leslieecv/EL6050_project/Examen/Imagenes/Presentación/loraGE2.png

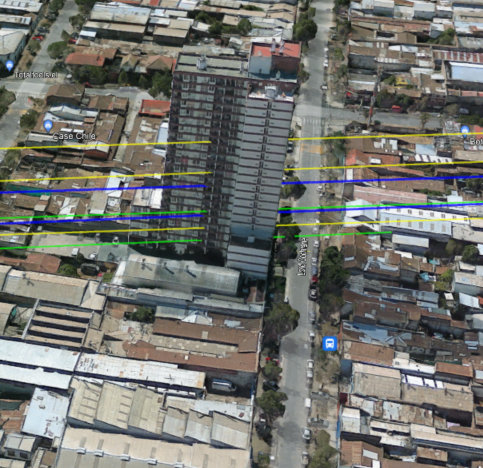
Examen/Imagenes/Presentación/loraGE2.png
