leslieecv/EL6050_project/Examen/Imagenes/Presentación/P_fig3.jpg

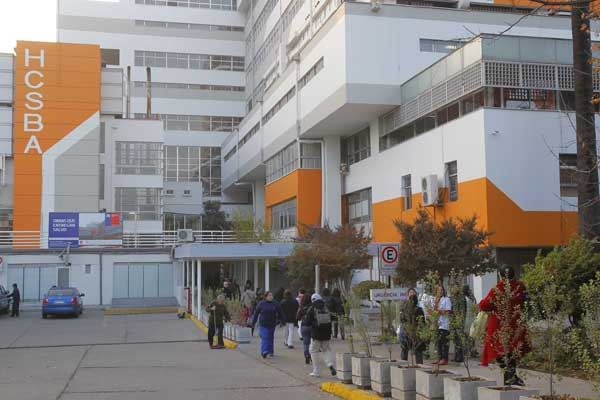
Examen/Imagenes/Presentación/P_fig3.jpg
