leslieecv/EL6050_project/README.md

# Proyecto de curso EL6050

- Leslie Cárdenas
- Nicolás Ruminot

Link de repositorio:  

[https://github.com/leslieecv/EL6050_project.git](https://github.com/leslieecv/EL6050_project.git)
