leslieecv/EL6050_project/T3/lista_compras.pdf

# | Componente | Símbolo en la PCB | Valor | Valor secundario Descripción | Cantidad/placa Precio/unidad Precio/cantidad Link compra

0-1 Placa diseñada | No se puede manufacturar solo una unidad | 1 | $640 | $640
| | | | | https://cart.jlcpcb.com/quote?rand=0.016247681288237947
0-2 Placa diseñada | | | (US$4) No considera en el total | 5 | $640 | $3.198
0-3 Envío placa | | | (US$23.99) Para 1 o 5 placas | | | $19.328
1 Conector SMA | ANTENA | | Conector jack para antena | 1 | $1.125 | $1.125 https://altronics.cl/conector-sma-f-pcb-th-1
2 Capacitor cerámico | C1, C2 | 22 pF | 35V | 2 | $30 | $60 https://www.kowka.cl/condensadores/106-285-condensador-ceramico.html#/120-ceramicos-22_pf
3 Capacitor cerámico | C3, C4, C5, C6, C7, C8 | 100 nF | 35V | 6 | $50 | $300 https://www.mechatronicstore.cl/condensadores-ceramicos-distintos-valores/
4 Capacitor electrolitico | C9, C10 | 47 uF | 25V | 2 | $189 | $378 https://www.pcfactory.cl/producto/31121-pcf-oem-capacitor-electrolitico-47uf-25v--10pcs
5 Capacitor electrolitico | C11, C12 | 10 uF | 50V | 2 | $189 | $378 https://www.pcfactory.cl/producto/31119-pcf-oem-capacitor-electrolitico-10uf-50v--10pcs
6 Diodo rectificador 1n4004 | D1, D2, D3, D4, D5, D6, D7, D8, D9 | 1 A | 50V | 9 | $69 | $621 https://maxelectronica.cl/componentes-electronicos/659-diodo-rectificador-1n4001-50v-1a-multiproposito-do41.html
7 Conector JST 6 pins | USB-SERIAL | | Para conectar CP2102 | 1 | $40 | $40 https://electronicaemedin.cl/producto/jst-6p-m/
8 ATMEGA2560-16AU | IC1 | | | 1 | $24.940 | $24.940 https://www.victronics.cl/index.php?route=product/product&product_id=2354
9 Regulador 7805T 5V | IC2 | 5 V | 20V entrada | 1 | $300 | $300 https://altronics.cl/integrado-regulador-voltaje-l7805
10 Regulador LM1117T 3V3 | IC3 | 3.3 V | 10V entrada | 1 | $460 | $460 https://altronics.cl/regulador-tension-voltaje-lm1117t-33?search=3.3V
11 Inductancia smd | L1 | 10 uH | | 1 | $2.469 | $2.469 https://www.mouser.cl/ProductDetail/Vishay-Dale/IHLP5050FDER100M01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
12 Conector JST 4 pins | LIDAR1, LIDAR2, TRSA, TRSB, TRSC | | Para conectar sensores | 5 | $200 | $1.000 https://zamperstore.cl/para-pcb/conector-jst-20mm-90-2-5p-para-soldar#/62-pines-4p
13 Microchip RN2483 | LRW-RN2903 | 915 MHz | Sacar el chip de la placa | 1 | $29.000 | $29.000 https://zamperstore.cl/lorawan/lorabee-915-mhz-rn2903
14 Leds 5mm | L_5V, L_DIST, L_RED, L_TRSA, L_TRSB, L_TRSC | 5 mm | Color blanco o azul | 6 | $51 | $304 https://altronics.cl/led-5mm-blanco
15 Conector jack | J1 | 2.1mm | Entrada de voltaje | 1 | $900 | $900 https://mcielectronics.cl/shop/product/conector-dc-para-pcb-9766/
16 Crystal HC18U-V | Q1 | 16 MHz | | 1 | $300 | $300 https://afel.cl/producto/oscilador-de-cristal-16mhz/
17 Resistencia SMD 1206 | R1, R2, R3, R4, R5, R6 | 100 Ohm 0.25W | 6 | $17 | $104 https://www.victronics.cl/index.php?route=product/product&path=104_136&product_id=1318
18 Resistencia SMD 1206 | R7 | 1M Ohm 0.25W | 1 | $17 | $17 https://www.victronics.cl/index.php?route=product/product&path=104_136&product_id=1958
19 Resistencia SMD 1206 | R8, R9, R10, R11, R12, R13, R14, R15 | 10k Ohm 0.25W | 8 | $17 | $139 https://www.victronics.cl/index.php?route=product/product&path=104_136&product_id=1326
20 MOSFET-N LGE2302 | Q2, Q3 | 20V | 2.1A 0.35W | 2 | $116 | $232 https://www.victronics.cl/index.php?route=product/product&product_id=2329&search=sot23
21 OPAMP LM358 | U1 | ±16 V | 700 kHz | 1 | $490 | $490 https://maxelectronica.cl/componentes-electronicos/706-circuito-integrado-amplificador-operacional-lm358.html
22 Conversor CP2102 | | | Debe tener 6 pines | 1 | $3.000 | $3.000 https://www.mechatronicstore.cl/conversor-tipo-usb-a-serial/
23 Lidar TF Mini | | | | 2 | $45.294 | $90.588 https://altronics.cl/lidar-tfmini-s
24 Sensor de corriente | | 0-10kA | Apto para un máximo de 10kA | 3 | $71.961 | $215.883 https://njchieful.en.made-in-china.com/product/expYrQIHJSVs/China-Open-Loop-Current-Sensor-CS10000hb-with-Window-Size-140-50mm.html
25 Antena direccional de exterior | | 915 Hz | | 1 | $115.000 | $115.000 https://zamperstore.cl/antenas-lora/antena-direccional-exterior-10dbi-915mhz-lora-lorawan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
TOTAL PARA 1 PLACA | | | | | | $507.996
