leslieecv/EL6050_project/Examen/Finanzas/Ejecución_del_proyecto.pdf

Ejecución_del_proyecto | Carta Gantt

## Semanas 1 2 3 4 5 6 7 8 9 10 11 12 13 14 15

## Diseño (2 personas) 5 DISEÑO Conversaciones con cliente para ajustar requerimientos 2

Desarrollo código microcontrolador 4 Desarrollo servidor 1 Desarrollo dashboard 2 IMPLEMENTACION -DESARROLLO Pruebas preliminares 3

Realizar cotizaciones 2 Compra de componentes 5 - Nacionales 2 - Internacionales 5 - Placa 3 IMPLEMENTACION -FABRICACION Ensamblado placas y cableado externo 3

## IMPLEMENTACIÓN -PUESTA EN MARCHA Pruebas de cada placa con sus perifericos 2

Instalación física de los dispositivos en el terreno 1 Pruebas de enlace 1 INSTALACIÓN Pruebas de despliegue de información en interfase 1

## Mantención - Anual 1 Reposición 1 PROCESOS AISLADOS Reportabilidad - Es continuo -

Ejecución_del_proyecto | Costos
| | Cantidad | Costo/cantidad | Costo | Link
Diseño | | | | $11.300.000
SUELDOS | Ingenierxs sin experiencia laboral (mensual) | 2 | $2.000.000 | $4.000.000
| Desarrollador (mensual) | 1 | $1.000.000 | $1.000.000
| Project Manager (mensual) | 2 | $2.000.000 | $4.000.000
OTROS | Arriendo oficina (mensual) | 2 | $1.000.000 | $2.000.000
| Servicios básicos (mensual) | 2 | $150.000 | $300.000
Implementación | | | | $11.425.494
SUELDOS | Ingenierxs sin experiencia laboral (mensual) | 1 | $1.000.000 | $1.000.000
| Técnicx electrónico (mensual) | 0,5 | $700.000 | $350.000
| Project Manager (mensual) | 1 | $2.000.000 | $2.000.000
| Diseñador/a (hora) | 40 | $17.500 | $700.000
INTERIOR PLACA | Compras nacionales | 10 | $272.145 | $2.721.451
| Compra sensores (China) | 10 | $215.883 | $2.158.830
| Fabricación placas (China) | 10 | $640 | $6.396
| Envio nacional | 4 | $5.000 | $20.000
| Envio sensores | 1 | $150.000 | $150.000
| Envio placas | 1 | $19.328 | $19.328
EXTERIOR PLACA | Compras nacionales | 10 | $22.952 | $229.519
| Envio nacional | 2 | $5.000 | $10.000

## MAQUINAS y HERRAMIENTAS

| Impresora 3D | 2 | $270.000 | $540.000 | https://www.pcfactory.cl/producto/47010-creality-impresora-3d-ender-3-v2-neo
| Estación de soldado | 2 | $179.990 | $359.980 | https://www.mundoreballing.cl/inicio/5-atten-at8586-estacion-de-soldar-2-en-1-cautin-aire-caliente-750-watts.html
CONSUMIBLE EXTRA | Cable AWG 30 (250m) | 1 | $9.990 | $9.990 | https://www.cimech3d.cl/producto/rollo-de-cable-de-cobre-250m-con-proteccion-de-30awg/
OTROS | Arriendo oficina (mensual) | 1 | $1.000.000 | $1.000.000
| Servicios básicos (mensual) | 1 | $150.000 | $150.000
Operación (anual) | | | | $4.700.383
INSTALACIÓN | Ingenierxs sin experiencia laboral (mensual) | 2 | $1.000.000 | $2.000.000
MANTENCIÓN -DISPOSITIVOS | Técnicx electrónico (mensual) | 1 | $700.000 | $700.000
MANTENCIÓN -PLATAFORMA | Desarrollador (mensual) | 1 | $1.000.000 | $1.000.000

Ejecución_del_proyecto | Costos
| | Cantidad | Costo/cantidad | Costo | Link
REPOSICIÓN | Dispositivos dados de baja (mensual) | 0,02 | $23.000 | $383
REPORTABILIDAD | Analista (mensual) | 1 | $1.000.000 | $1.000.000
| TOTAL | | | $27.425.877

Ejecución_del_proyecto | HorasDiseño
| Tarea 1 | Tarea 2 | Tarea 3 | Tarea 4 - Diseño | Examen | TOTAL hrs de dedicación | TOTAL jornadas laborales | Tarea 4 - Implementación | Hrs de dedicación
Leslie | 15 | 25 | 25 | 10 | 20 | 95 | 11,875 | 15
Nicolas | 15 | 35 | 10 | 10 | 20 | 90 | 11,25 | 15
TOTAL equipo | 30 | 60 | 35 | 20 | 40 | 185 | 23,125 | 30 | 3,75

## Solo diseño de máquinas

Ejecución_del_proyecto | ListaCompras-InteriorPCB
# | Componente | Símbolo en la PCB | Valor | Valor secundario | Descripción | Cantidad/placa | Precio/unidad | Precio/cantidad | Tiempo | Link compra

0-1 | Placa diseñada | | | | No se puede manufacturar solo una unidad | 1 | $640 | $640
0-2 | Placa diseñada | | | | (US$4) No considera en el total | 5 | $640 | $3.198
0-3 | Envío placa | | | | (US$23.99) Para 1 o 5 placas | | | $19.328
1 | Conector SMA | ANTENA | | | Conector jack para antena | 1 | $1.125 | $1.125
9 días | https://cart.jlcpcb.com/quote?rand=0.016247681288237947

5 días

https://altronics.cl/conector-sma-f-pcb-th-1
2 | Capacitor cerámico | C1, C2 | 22 pF | 35V | 2 | $30 | $60 | https://www.kowka.cl/condensadores/106-285-condensador-ceramico.html#/120-ceramicos-22_pf
3 | Capacitor cerámico | C3, C4, C5, C6, C7, C8 | 100 nF | 35V | 6 | $50 | $300 | https://www.mechatronicstore.cl/condensadores-ceramicos-distintos-valores/
4 | Capacitor electrolitico | C9, C10 | 47 uF | 25V | 2 | $189 | $378 | https://www.pcfactory.cl/producto/31121-pcf-oem-capacitor-electrolitico-47uf-25v--10pcs
5 | Capacitor electrolitico | C11, C12 | 10 uF | 50V | 2 | $189 | $378 | https://www.pcfactory.cl/producto/31119-pcf-oem-capacitor-electrolitico-10uf-50v--10pcs
6 | Diodo rectificador 1n4004 | D1, D2, D3, D4, D5, D6, D7, D8, D9 | 1 A | 50V | 9 | $69 | $621 | https://maxelectronica.cl/componentes-electronicos/659-diodo-rectificador-1n4001-50v-1a-multiproposito-do41.html
7 | Conector JST 6 pins | USB-SERIAL | Para conectar CP2102 | 1 | $40 | $40 | https://electronicaemedin.cl/producto/jst-6p-m/
8 | ATMEGA2560-16AU | IC1 | 1 | $24.940 | $24.940 | https://www.victronics.cl/index.php?route=product/product&product_id=2354
9 | Regulador 7805T 5V | IC2 | 5 V | 20V entrada | 1 | $300 | $300 | https://altronics.cl/integrado-regulador-voltaje-l7805
10 | Regulador LM1117T 3V3 | IC3 | 3.3 V | 10V entrada | 1 | $460 | $460 | https://altronics.cl/regulador-tension-voltaje-lm1117t-33?search=3.3V
11 | Inductancia smd | L1 | 10 uH | 1 | $2.469 | $2.469 | https://www.mouser.cl/ProductDetail/Vishay-Dale/IHLP5050FDER100M01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
12 | Conector JST 4 pins | LIDAR1, LIDAR2, TRSA, TRSB, TRSC | Para conectar sensores | 5 | $200 | $1.000 | https://zamperstore.cl/para-pcb/conector-jst-20mm-90-2-5p-para-soldar#/62-pines-4p
13 | Microchip RN2483 | LRW-RN2903 | 915 MHz | Sacar el chip de la placa | 1 | $29.000 | $29.000 | https://zamperstore.cl/lorawan/lorabee-915-mhz-rn2903
14 | Leds 5mm | L_5V, L_DIST, L_RED, L_TRSA, L_TRSB, L_TRSC | 5 mm | Color blanco o azul | 6 | $51 | $304 | https://altronics.cl/led-5mm-blanco
15 | Conector jack | J1 | 2.1mm | Entrada de voltaje | 1 | $900 | $900 | https://mcielectronics.cl/shop/product/conector-dc-para-pcb-9766/
16 | Crystal HC18U-V | Q1 | 16 MHz | 1 | $300 | $300 | https://afel.cl/producto/oscilador-de-cristal-16mhz/
17 | Resistencia SMD 1206 | R1, R2, R3, R4, R5, R6 | 100 Ohm | 0.25W | 6 | $17 | $104 | https://www.victronics.cl/index.php?route=product/product&path=104_136&product_id=1318
18 | Resistencia SMD 1206 | R7 | 1M Ohm | 0.25W | 1 | $17 | $17 | https://www.victronics.cl/index.php?route=product/product&path=104_136&product_id=1958
19 | Resistencia SMD 1206 | R8, R9, R10, R11, R12, R13, R14, R15 | 10k Ohm | 0.25W | 8 | $17 | $139 | https://www.victronics.cl/index.php?route=product/product&path=104_136&product_id=1326
20 | MOSFET-N LGE2302 | Q2, Q3 | 20V | 2.1A 0.35W | 2 | $116 | $232 | https://www.victronics.cl/index.php?route=product/product&product_id=2329&search=sot23
21 | OPAMP LM358 | U1 | ±16 V | 700 kHz | 1 | $490 | $490 | https://maxelectronica.cl/componentes-electronicos/706-circuito-integrado-amplificador-operacional-lm358.html
22 | Conversor CP2102 | Debe tener 6 pines | 1 | $3.000 | $3.000 | https://www.mechatronicstore.cl/conversor-tipo-usb-a-serial/
23 | Lidar TF Mini | 2 | $45.294 | $90.588 | https://altronics.cl/lidar-tfmini-s
25 | Antena direccional de exterior | 915 Hz | 1 | $115.000 | $115.000 | https://zamperstore.cl/antenas-lora/antena-direccional-exterior-10dbi-915mhz-lora-lorawan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
24 | Sensor de corriente | 0-10kA | Apto para un máximo de 10kA | 3 | $71.961 | $215.883 | 14 días | https://njchieful.en.made-in-china.com/product/expYrQIHJSVs/China-Open-Loop-Current-Sensor-CS10000hb-with-Window-Size-140-50mm.html
TOTAL PARA 1 PLACA | $507.996
Valor compra nacional | $272.145
Valor compra internacional | $215.883
Valor fabricacion placa | $640

Ejecución_del_proyecto | ListaCompra-ExteriorPCB
Descripción | Cantidad/carcasa | Precio/unidad | Precio/cantidad | Tiempo | Link compra
Filamento PLA 1kg | 0,1 | $16.990 | $1.699 | 5 dias

## https://www.cimech3d.cl/producto/filamento-pla-para-impresion-3d-marca-esun-1-75mm-1kg/

Pernos M3x25mm (50un) | 0,08 | $2.600 | $208 | https://www.cimech3d.cl/producto/perno-m3-zincado-pack-50/
Estaño con 2% flux (1 tubo) | 0,3 | $2.500 | $750 | https://altronics.cl/tubo-soldadura-1mm-16g?search=estaño
Termotractil 4mm (10mts) | 0,1 | $2.500 | $250 | https://altronics.cl/tubo-termoretractil-4mm-10mt
Tuerca de inserción 3mm (10un) | 0,4 | $1.000 | $400 | https://zamperstore.cl/montaje/tuerca-de-insercion-m3-insert-pack-de-10-3mm
Alcohol isopropolico 1lt | 0,01 | $4.990 | $50 | https://www.mundoreballing.cl/inicio/225-alcohol-isopropilico-alta-pureza-999-1-litro.html
Cable 24 AWG (10 mts) | 0,05 | $2.500 | $125 | https://www.cimech3d.cl/producto/cable-cubierto-de-silicona-con-resitencia-al-calor-24awg-negro/
Cable coaxial RG-6 (20 mts) | 3 | $6.490 | $19.470 | https://www.easy.cl/cable-coaxial-rg-6-20-mts-negro-electromex-932249/p
TOTAL 1 EXTERIOR PLACA | | | $22.952
