leslieecv/EL6050_project/T3/board.pdf

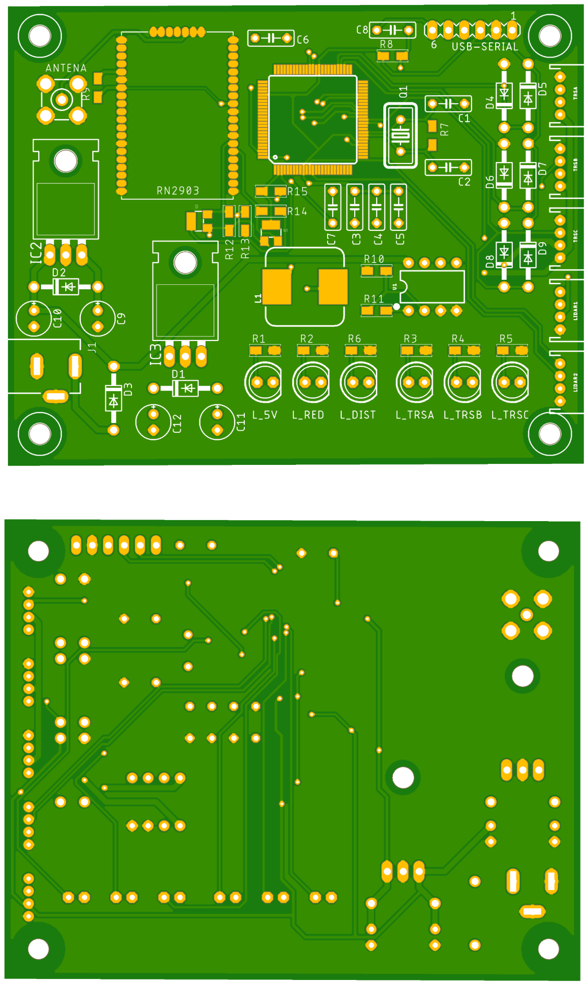
[picture p31: page 1]
