leslieecv/EL6050_project/Examen/Carcasa/caja_EL6050_close v5.png

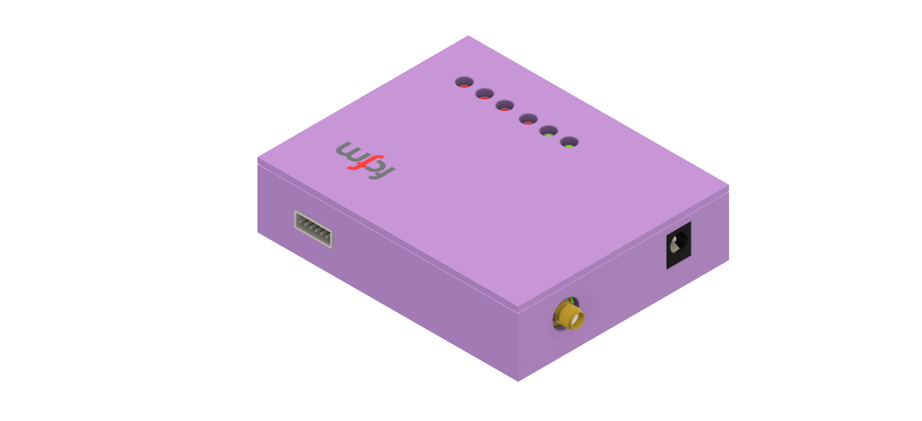
Examen/Carcasa/caja_EL6050_close v5.png
