leslieecv/EL6050_project/Examen/Carcasa/caja_EL6050_open v5.png

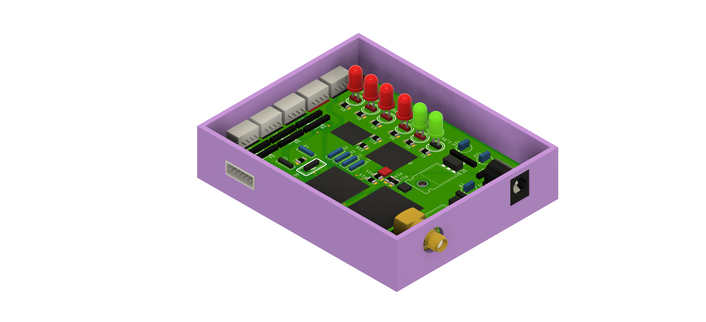
Examen/Carcasa/caja_EL6050_open v5.png
