leslieecv/EL6050_project/Examen/Carcasa/carcasa_iso.png

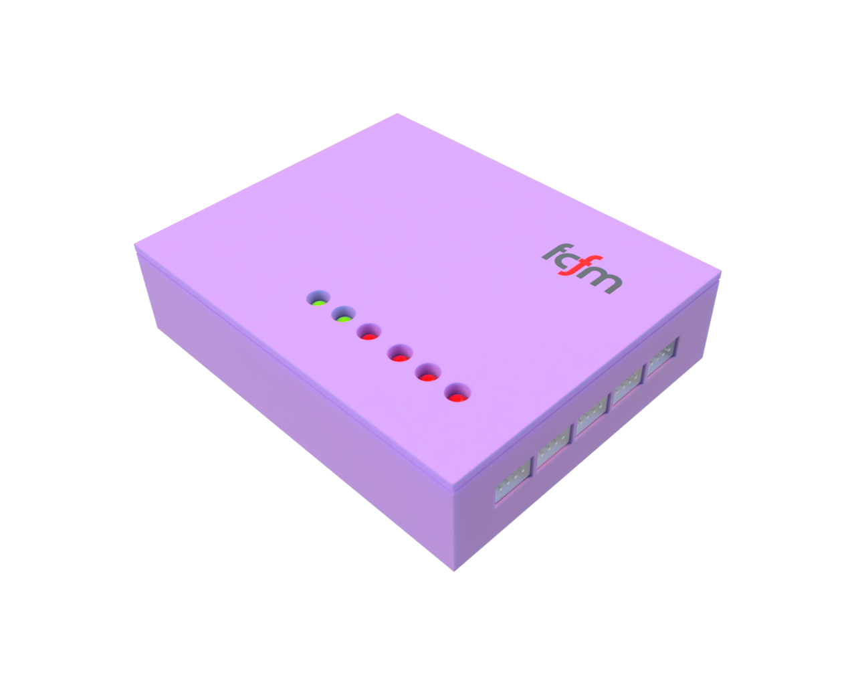
Examen/Carcasa/carcasa_iso.png
