leslieecv/EL6050_project/Examen/Imagenes/Presentación/loraGE1.png

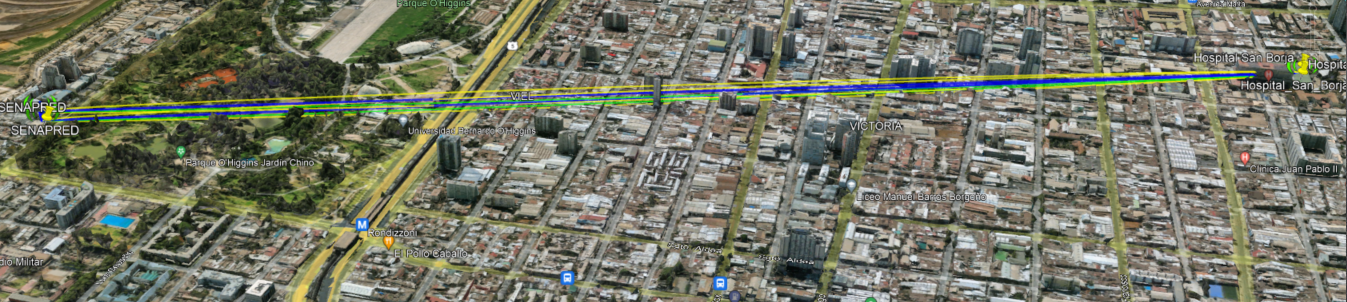
Examen/Imagenes/Presentación/loraGE1.png
