leslieecv/EL6050_project/Examen/Imagenes/Presentación/P_fig4.png

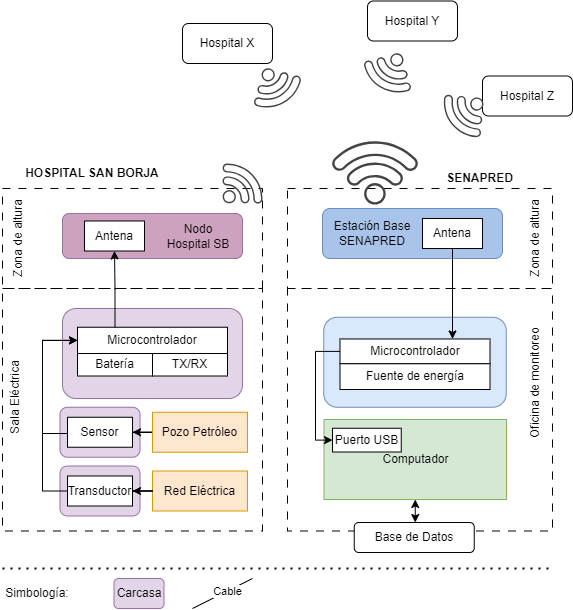
Examen/Imagenes/Presentación/P_fig4.png
