leslieecv/EL6050_project/Examen/Imagenes/Presentación/P_fig5.png

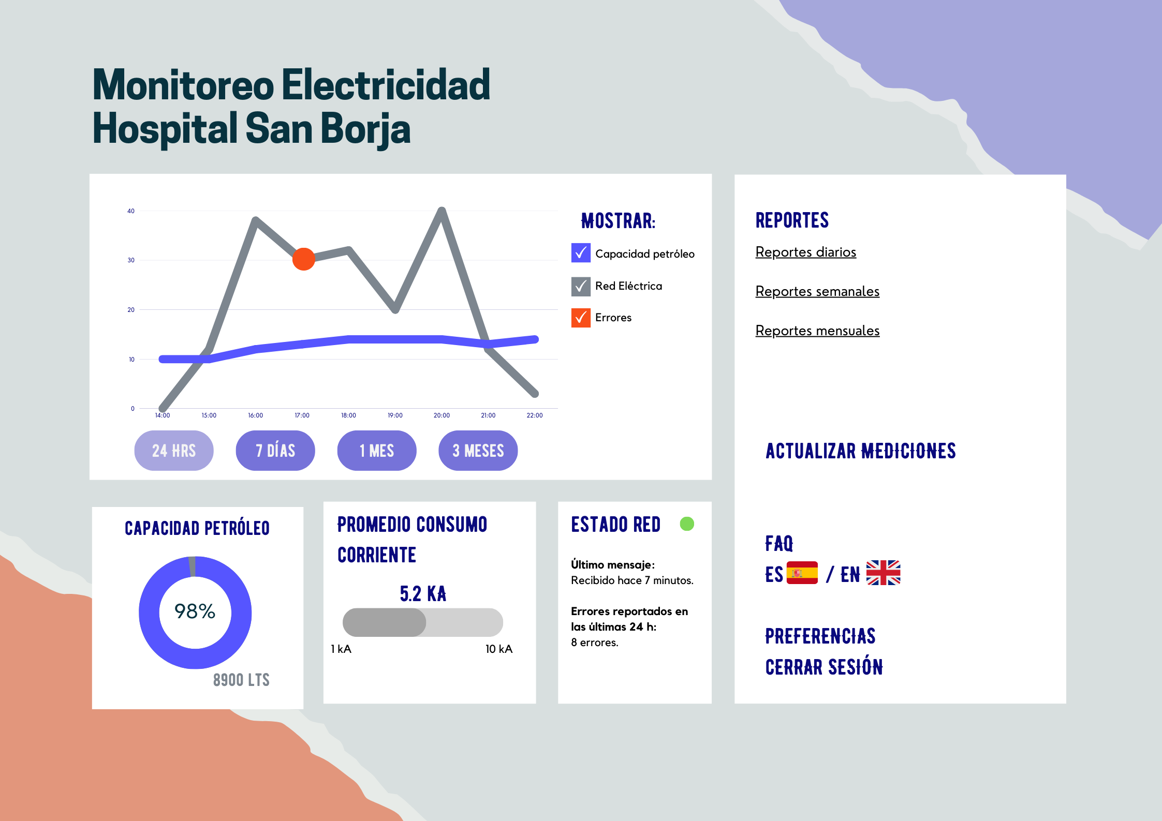
Examen/Imagenes/Presentación/P_fig5.png
