leslieecv/EL6050_project/Examen/Imagenes/Presentación/P_fig6A.png

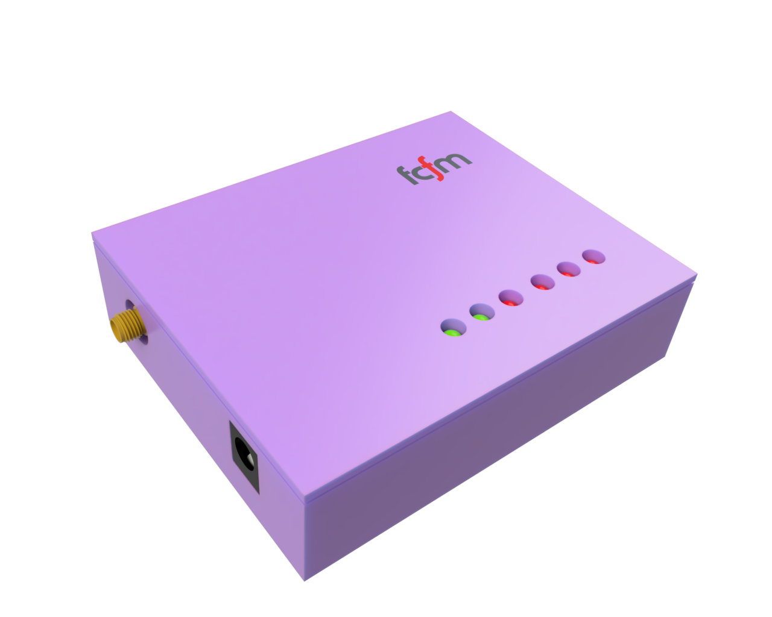
Examen/Imagenes/Presentación/P_fig6A.png
