leslieecv/EL6050_project/Examen/Imagenes/Presentación/P_fig6B.png

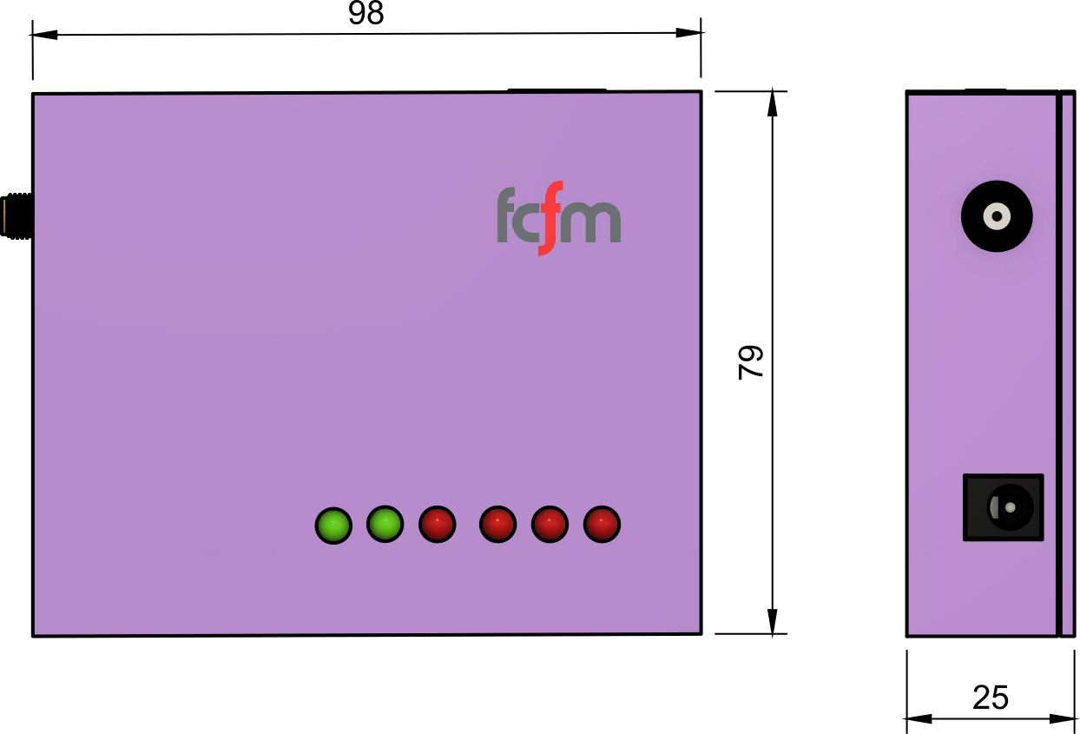
Examen/Imagenes/Presentación/P_fig6B.png
