leslieecv/EL6050_project/Examen/Imagenes/Presentación/P_fig7.png

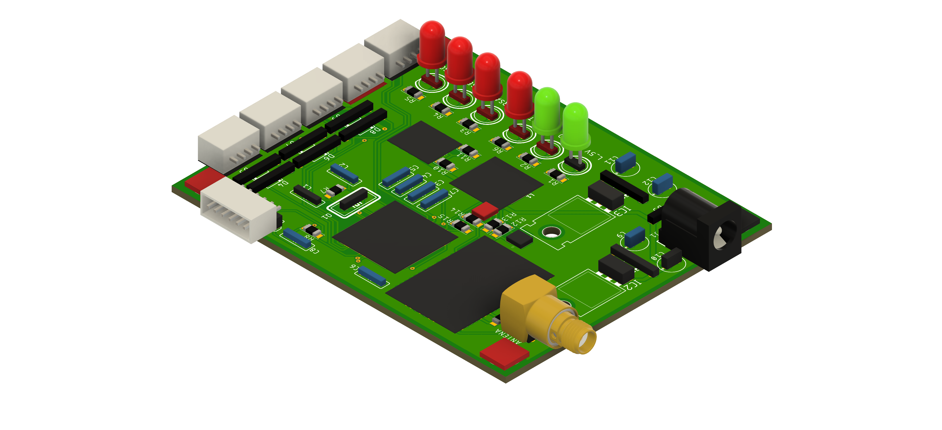
Examen/Imagenes/Presentación/P_fig7.png
