leslieecv/EL6050_project/Examen/Imagenes/Presentación/P_fig9.png

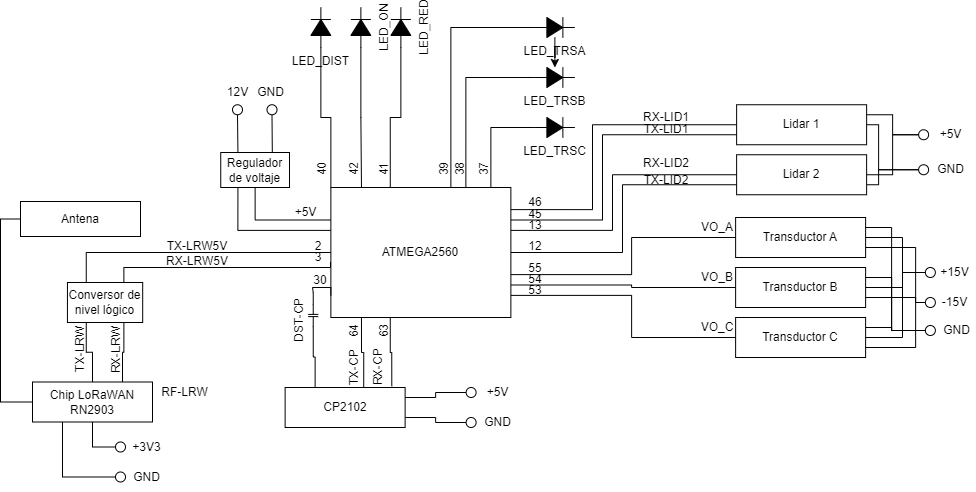
Examen/Imagenes/Presentación/P_fig9.png
