leslieecv/EL6050_project/Examen/Imagenes/Presentación/P_fig21.png

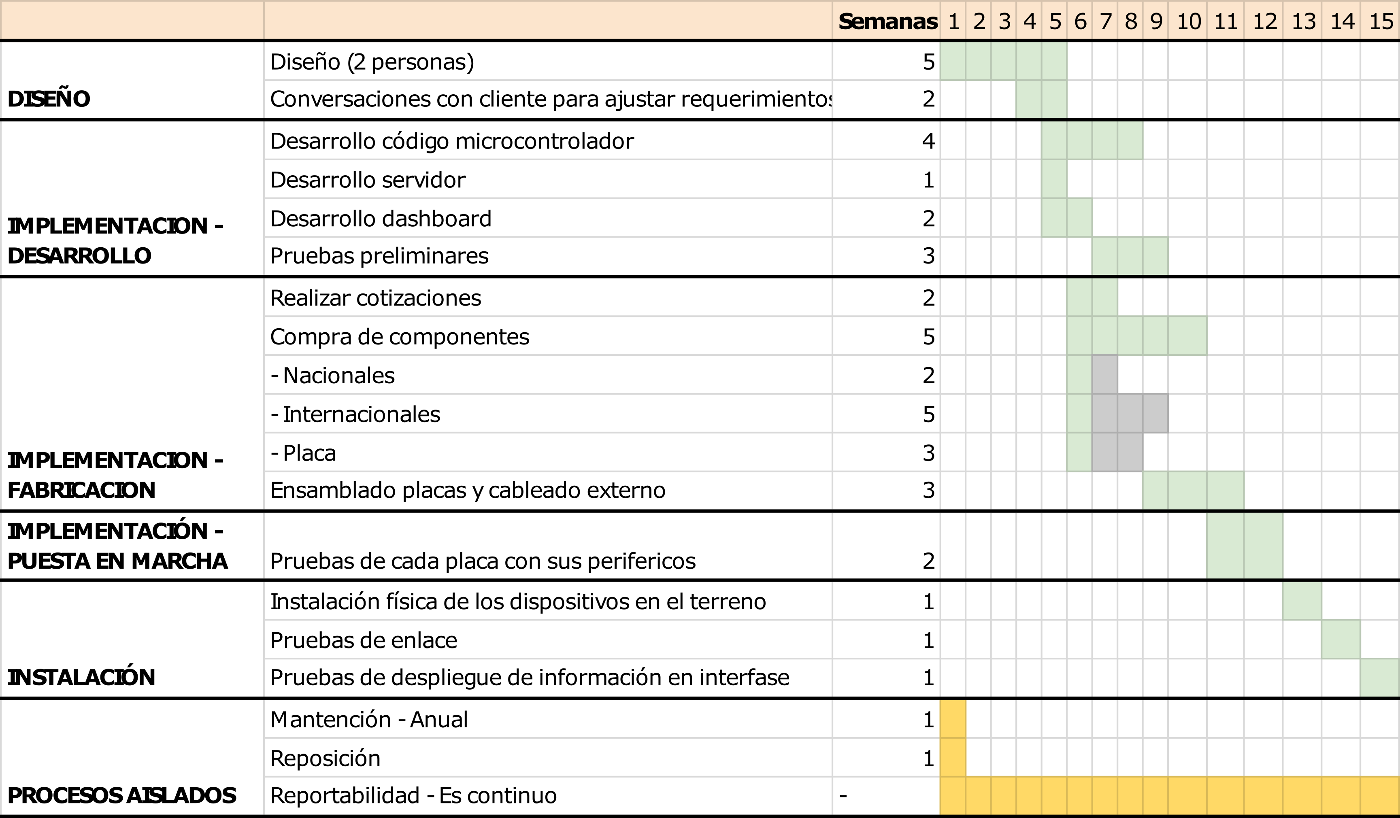
Examen/Imagenes/Presentación/P_fig21.png
