leslieecv/EL6050_project/Examen/Imagenes/Presentación/P_fig23A.png

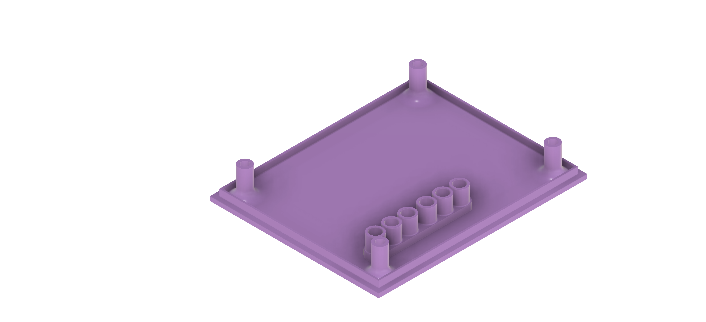
Examen/Imagenes/Presentación/P_fig23A.png
