leslieecv/EL6050_project/Examen/Imagenes/Presentación/P_fig23B.png

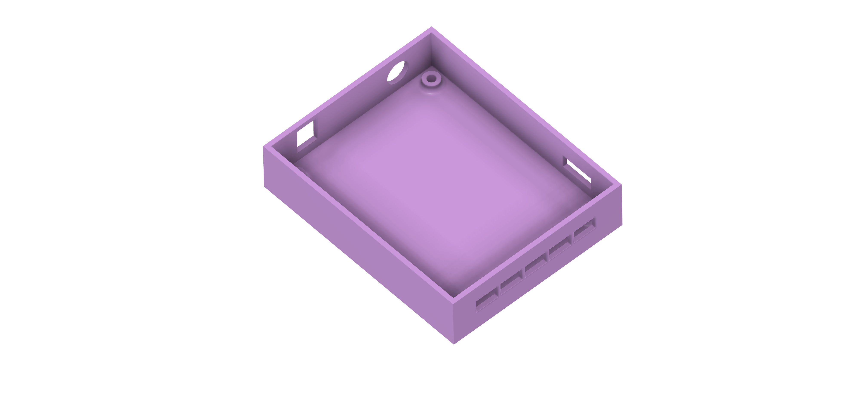
Examen/Imagenes/Presentación/P_fig23B.png
