leslieecv/EL6050_project/Examen/Imagenes/T2/T2_fig5.png

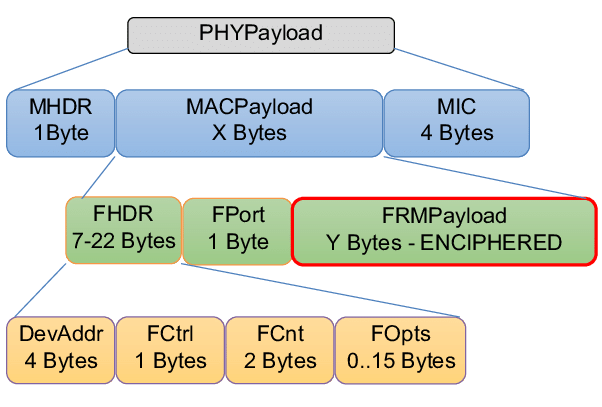
Examen/Imagenes/T2/T2_fig5.png
