leslieecv/EL6050_project/Examen/Imagenes/T2/T2_fig6.png

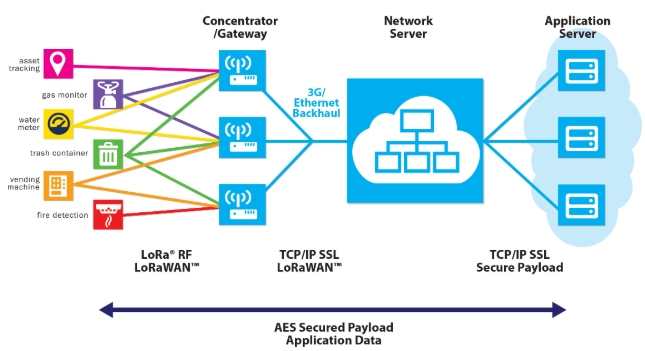
Examen/Imagenes/T2/T2_fig6.png
