leslieecv/EL6050_project/Examen/Imagenes/T3/T3_fig2.png

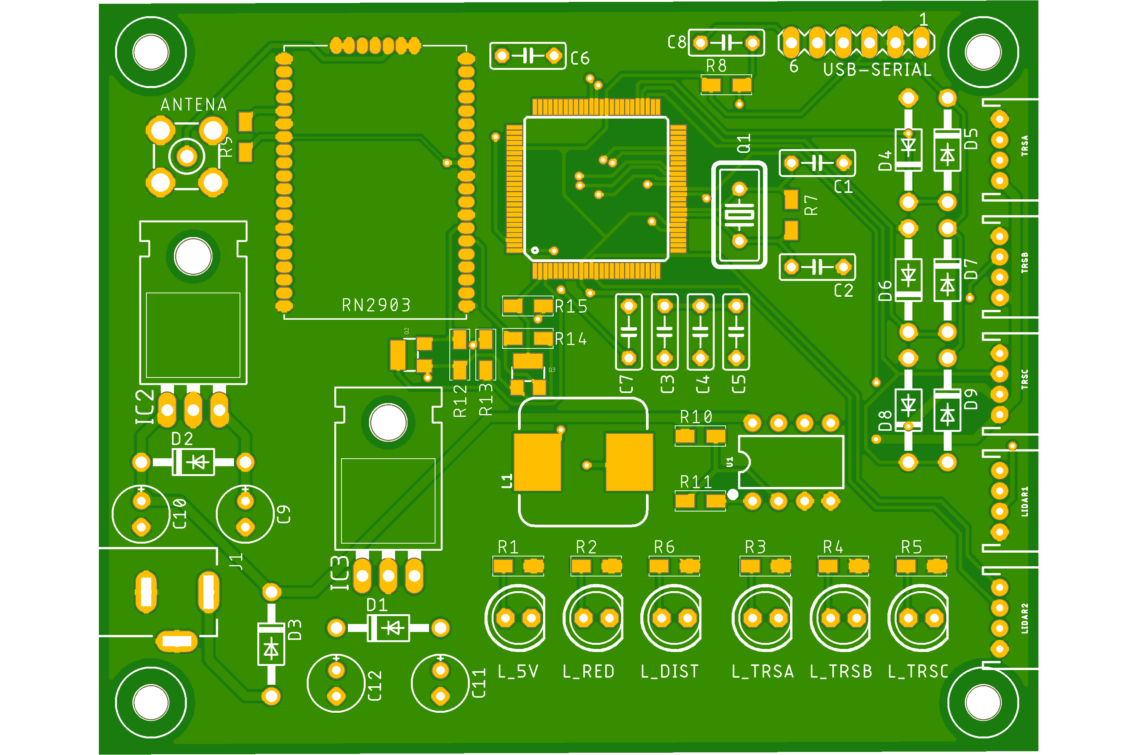
Examen/Imagenes/T3/T3_fig2.png
