leslieecv/EL6050_project/Examen/src/b_main.png

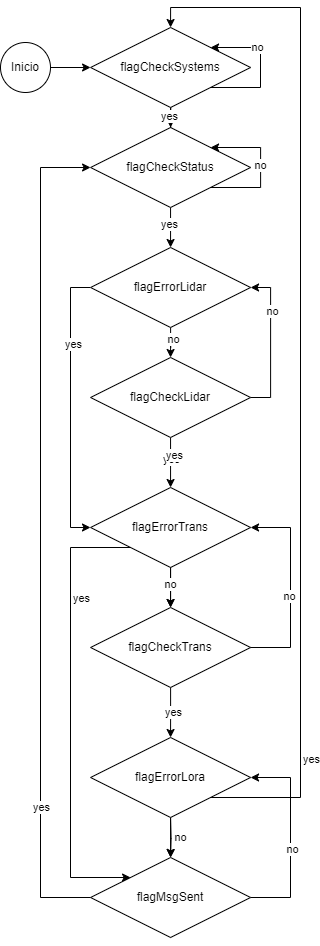
Examen/src/b_main.png
