leslieecv/EL6050_project/Examen/src/DiagramaRed.png

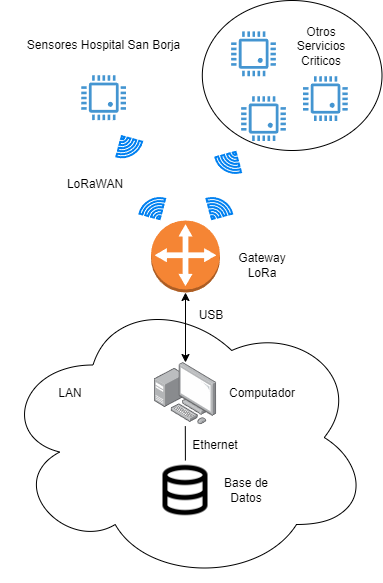
Examen/src/DiagramaRed.png
