leslieecv/EL6050_project/Examen/src/Lora.png

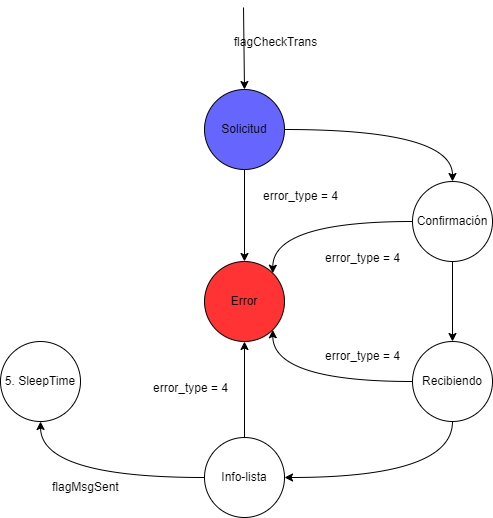
Examen/src/Lora.png
