leslieecv/EL6050_project/Examen/src/Sleep.png

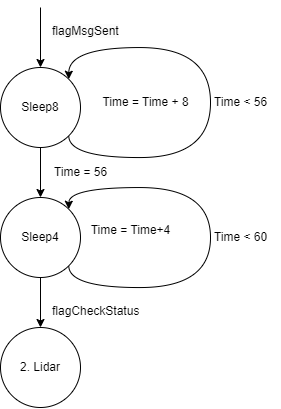
Examen/src/Sleep.png
