leslieecv/EL6050_project/Examen/src/UML.png

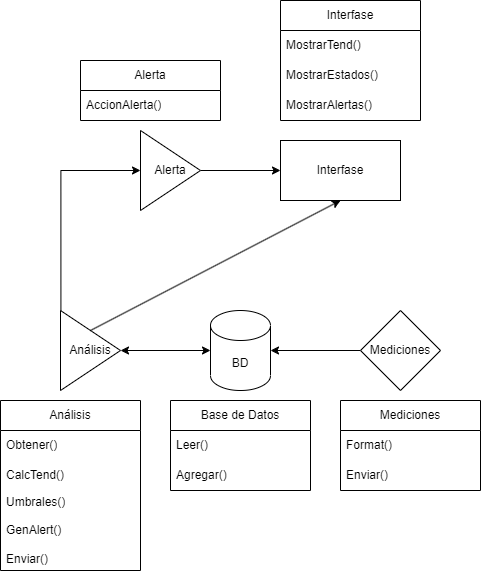
Examen/src/UML.png
