leslieecv/EL6050_project/Examen/Finanzas/Ejecución_del_proyecto.xlsx

Sheet: Carta Gantt
 |  | Semanas | 1 | 2 | 3 | 4 | 5 | 6 | 7 | 8 | 9 | 10 | 11 | 12 | 13 | 14 | 15
DISEÑO | Diseño (2 personas) | 4.625
 | Conversaciones con cliente para ajustar requerimientos | 2
IMPLEMENTACION - DESARROLLO | Desarrollo código microcontrolador | 4
 | Desarrollo servidor | 1
 | Desarrollo dashboard | 2
 | Pruebas preliminares | 3
IMPLEMENTACION - FABRICACION | Realizar cotizaciones | 2
 | Compra de componentes | 5
 | - Nacionales | 2
 | - Internacionales | 5
 | - Placa | 3
 | Ensamblado placas y cableado externo | 3
IMPLEMENTACIÓN - PUESTA EN MARCHA | Pruebas de cada placa con sus perifericos | 2
INSTALACIÓN | Instalación física de los dispositivos en el terreno | 1
 | Pruebas de enlace | 1
 | Pruebas de despliegue de información en interfase | 1
PROCESOS AISLADOS | Mantención - Anual | 1
 | Reposición | 1
 | Reportabilidad - Es continuo | -

Sheet: Costos
 |  | Cantidad | Costo/cantidad | Costo | Link
Diseño |  |  |  | $11300000
SUELDOS | Ingenierxs sin experiencia laboral (mensual) | 2 | $2000000 | $4000000
 | Desarrollador (mensual) | 1 | $1000000 | $1000000
 | Project Manager (mensual) | 2 | $2000000 | $4000000
OTROS | Arriendo oficina (mensual) | 2 | $1000000 | $2000000
 | Servicios básicos (mensual) | 2 | $150000 | $300000
Implementación |  |  |  | $11425494
SUELDOS | Ingenierxs sin experiencia laboral (mensual) | 1 | $1000000 | $1000000
 | Técnicx electrónico (mensual) | 0.5 | $700000 | $350000
 | Project Manager (mensual) | 1 | $2000000 | $2000000
 | Diseñador/a (hora) | 40 | $17500 | $700000
INTERIOR PLACA | Compras nacionales | 10 | $272145.1 | $2721451
 | Compra sensores (China) | 10 | $215883 | $2158830
 | Fabricación placas (China) | 10 | $639.6 | $6396
 | Envio nacional | 4 | $5000 | $20000
 | Envio sensores | 1 | $150000 | $150000
 | Envio placas | 1 | $19328 | $19328
EXTERIOR PLACA | Compras nacionales | 10 | $22951.9 | $229519
 | Envio nacional | 2 | $5000 | $10000
MAQUINAS y HERRAMIENTAS | Impresora 3D | 2 | $270000 | $540000 | https://www.pcfactory.cl/producto/47010-creality-impresora-3d-ender-3-v2-neo
 | Estación de soldado | 2 | $179990 | $359980 | https://www.mundoreballing.cl/inicio/5-atten-at8586-estacion-de-soldar-2-en-1-cautin-aire-caliente-750-watts.html
CONSUMIBLE EXTRA | Cable AWG 30 (250m) | 1 | $9990 | $9990 | https://www.cimech3d.cl/producto/rollo-de-cable-de-cobre-250m-con-proteccion-de-30awg/
OTROS | Arriendo oficina (mensual) | 1 | $1000000 | $1000000
 | Servicios básicos (mensual) | 1 | $150000 | $150000
Operación (anual) |  |  |  | $4700383.333
INSTALACIÓN | Ingenierxs sin experiencia laboral (mensual) | 2 | $1000000 | $2000000
MANTENCIÓN - DISPOSITIVOS | Técnicx electrónico (mensual) | 1 | $700000 | $700000
MANTENCIÓN - PLATAFORMA | Desarrollador (mensual) | 1 | $1000000 | $1000000
REPOSICIÓN | Dispositivos dados de baja (mensual) | 0.02 | $23000 | $383.3333333
REPORTABILIDAD | Analista (mensual) | 1 | $1000000 | $1000000
 | TOTAL |  |  | $27425877.33

Sheet: HorasDiseño
 | Tarea 1 | Tarea 2 | Tarea 3 | Tarea 4 - Diseño | Examen | TOTAL hrs de dedicación | TOTAL jornadas laborales | Tarea 4 - Implementación | Hrs de dedicación
Leslie | 15 | 25 | 25 | 10 | 20 | 95 | 11.875 | 15
Nicolas | 15 | 35 | 10 | 10 | 20 | 90 | 11.25 | 15
TOTAL equipo | 30 | 60 | 35 | 20 | 40 | 185 | 23.125 | 30 | 3.75
 |  |  |  | Solo diseño de máquinas

Sheet: ListaCompras-InteriorPCB
# | Componente | Símbolo en la PCB | Valor | Valor secundario | Descripción | Cantidad/placa | Precio/unidad | Precio/cantidad | Tiempo | Link compra
0-1 | Placa diseñada |  |  |  | No se puede manufacturar solo una unidad | 1 | $639.6 | $639.6 | 9 días | https://cart.jlcpcb.com/quote?rand=0.016247681288237947
0-2 | Placa diseñada |  |  |  | (US$4) No considera en el total | 5 | $639.6 | $3198
0-3 | Envío placa |  |  |  | (US$23.99) Para 1 o 5 placas |  |  | $19328
1 | Conector SMA | ANTENA |  |  | Conector jack para antena | 1 | $1125 | $1125 | 5 días | https://altronics.cl/conector-sma-f-pcb-th-1
2 | Capacitor cerámico | C1, C2 | 22 pF | 35V |  | 2 | $30 | $60 |  | https://www.kowka.cl/condensadores/106-285-condensador-ceramico.html#/120-ceramicos-22_pf
3 | Capacitor cerámico | C3, C4, C5, C6, C7, C8 | 100 nF | 35V |  | 6 | $50 | $300 |  | https://www.mechatronicstore.cl/condensadores-ceramicos-distintos-valores/
4 | Capacitor electrolitico | C9, C10 | 47 uF | 25V |  | 2 | $189 | $378 |  | https://www.pcfactory.cl/producto/31121-pcf-oem-capacitor-electrolitico-47uf-25v--10pcs
5 | Capacitor electrolitico | C11, C12 | 10 uF | 50V |  | 2 | $189 | $378 |  | https://www.pcfactory.cl/producto/31119-pcf-oem-capacitor-electrolitico-10uf-50v--10pcs
6 | Diodo rectificador 1n4004 | D1, D2, D3, D4, D5, D6, D7, D8, D9 | 1 A | 50V |  | 9 | $69 | $621 |  | https://maxelectronica.cl/componentes-electronicos/659-diodo-rectificador-1n4001-50v-1a-multiproposito-do41.html
7 | Conector JST 6 pins | USB-SERIAL |  |  | Para conectar CP2102 | 1 | $40 | $40 |  | https://electronicaemedin.cl/producto/jst-6p-m/
8 | ATMEGA2560-16AU | IC1 |  |  |  | 1 | $24940 | $24940 |  | https://www.victronics.cl/index.php?route=product/product&product_id=2354
9 | Regulador 7805T 5V | IC2 | 5 V |  | 20V entrada | 1 | $300 | $300 |  | https://altronics.cl/integrado-regulador-voltaje-l7805
10 | Regulador LM1117T 3V3 | IC3 | 3.3 V |  | 10V entrada | 1 | $459.5 | $459.5 |  | https://altronics.cl/regulador-tension-voltaje-lm1117t-33?search=3.3V
11 | Inductancia smd | L1 | 10 uH |  |  | 1 | $2469 | $2469 |  | https://www.mouser.cl/ProductDetail/Vishay-Dale/IHLP5050FDER100M01
12 | Conector JST 4 pins | LIDAR1, LIDAR2, TRSA, TRSB, TRSC |  |  | Para conectar sensores | 5 | $200 | $1000 |  | https://zamperstore.cl/para-pcb/conector-jst-20mm-90-2-5p-para-soldar#/62-pines-4p
13 | Microchip RN2483 | LRW-RN2903 | 915 MHz |  | Sacar el chip de la placa | 1 | $29000 | $29000 |  | https://zamperstore.cl/lorawan/lorabee-915-mhz-rn2903
14 | Leds 5mm | L_5V, L_DIST, L_RED, L_TRSA, L_TRSB, L_TRSC | 5 mm |  | Color blanco o azul | 6 | $50.6 | $303.6 |  | https://altronics.cl/led-5mm-blanco
15 | Conector jack | J1 | 2.1mm |  | Entrada de voltaje | 1 | $900 | $900 |  | https://mcielectronics.cl/shop/product/conector-dc-para-pcb-9766/
16 | Crystal HC18U-V | Q1 | 16 MHz |  |  | 1 | $300 | $300 |  | https://afel.cl/producto/oscilador-de-cristal-16mhz/
17 | Resistencia SMD 1206 | R1, R2, R3, R4, R5, R6 | 100 Ohm | 0.25W |  | 6 | $17.4 | $104.4 |  | https://www.victronics.cl/index.php?route=product/product&path=104_136&product_id=1318
18 | Resistencia SMD 1206 | R7 | 1M Ohm | 0.25W |  | 1 | $17.4 | $17.4 |  | https://www.victronics.cl/index.php?route=product/product&path=104_136&product_id=1958
19 | Resistencia SMD 1206 | R8, R9, R10, R11, R12, R13, R14, R15 | 10k Ohm | 0.25W |  | 8 | $17.4 | $139.2 |  | https://www.victronics.cl/index.php?route=product/product&path=104_136&product_id=1326
20 | MOSFET-N LGE2302 | Q2, Q3 | 20V | 2.1A 0.35W |  | 2 | $116 | $232 |  | https://www.victronics.cl/index.php?route=product/product&product_id=2329&search=sot23
21 | OPAMP LM358 | U1 | ±16 V | 700 kHz |  | 1 | $490 | $490 |  | https://maxelectronica.cl/componentes-electronicos/706-circuito-integrado-amplificador-operacional-lm358.html
22 | Conversor CP2102 |  |  |  | Debe tener 6 pines | 1 | $3000 | $3000 |  | https://www.mechatronicstore.cl/conversor-tipo-usb-a-serial/
23 | Lidar TF Mini |  |  |  |  | 2 | $45294 | $90588 |  | https://altronics.cl/lidar-tfmini-s
25 | Antena direccional de exterior |  | 915 Hz |  |  | 1 | $115000 | $115000 |  | https://zamperstore.cl/antenas-lora/antena-direccional-exterior-10dbi-915mhz-lora-lorawan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
24 | Sensor de corriente |  | 0-10kA |  | Apto para un máximo de 10kA | 3 | $71961 | $215883 | 14 días | https://njchieful.en.made-in-china.com/product/expYrQIHJSVs/China-Open-Loop-Current-Sensor-CS10000hb-with-Window-Size-140-50mm.html
 | TOTAL PARA 1 PLACA |  |  |  |  |  |  | $507995.7
 |  |  |  |  | Valor compra nacional |  |  | $272145.1
 |  |  |  |  | Valor compra internacional |  |  | $215883
 |  |  |  |  | Valor fabricacion placa |  |  | $639.6

Sheet: ListaCompra-ExteriorPCB
Descripción | Cantidad/carcasa | Precio/unidad | Precio/cantidad | Tiempo | Link compra
Filamento PLA 1kg | 0.1 | $16990 | $1699 | 5 dias | https://www.cimech3d.cl/producto/filamento-pla-para-impresion-3d-marca-esun-1-75mm-1kg/
Pernos M3x25mm (50un) | 0.08 | $2600 | $208 |  | https://www.cimech3d.cl/producto/perno-m3-zincado-pack-50/
Estaño con 2% flux (1 tubo) | 0.3 | $2500 | $750 |  | https://altronics.cl/tubo-soldadura-1mm-16g?search=estaño
Termotractil 4mm (10mts) | 0.1 | $2500 | $250 |  | https://altronics.cl/tubo-termoretractil-4mm-10mt
Tuerca de inserción 3mm (10un) | 0.4 | $1000 | $400 |  | https://zamperstore.cl/montaje/tuerca-de-insercion-m3-insert-pack-de-10-3mm
Alcohol isopropolico 1lt | 0.01 | $4990 | $49.9 |  | https://www.mundoreballing.cl/inicio/225-alcohol-isopropilico-alta-pureza-999-1-litro.html
Cable 24 AWG (10 mts) | 0.05 | $2500 | $125 |  | https://www.cimech3d.cl/producto/cable-cubierto-de-silicona-con-resitencia-al-calor-24awg-negro/
Cable coaxial RG-6 (20 mts) | 3 | $6490 | $19470 |  | https://www.easy.cl/cable-coaxial-rg-6-20-mts-negro-electromex-932249/p
TOTAL 1 EXTERIOR PLACA |  |  | $22951.9
