leslieecv/EL6050_project/(list of files, cad)

Other CAD files:
Examen/Carcasa/caja_EL6050.f3z
