leslieecv/EL6050_project/T3/schematic.pdf

Sheet: ABCD | 1 | 2 | 3 | 4 | 5 | 6 | ABCD 1 | 2 | 3 | 4 | 5 | 6

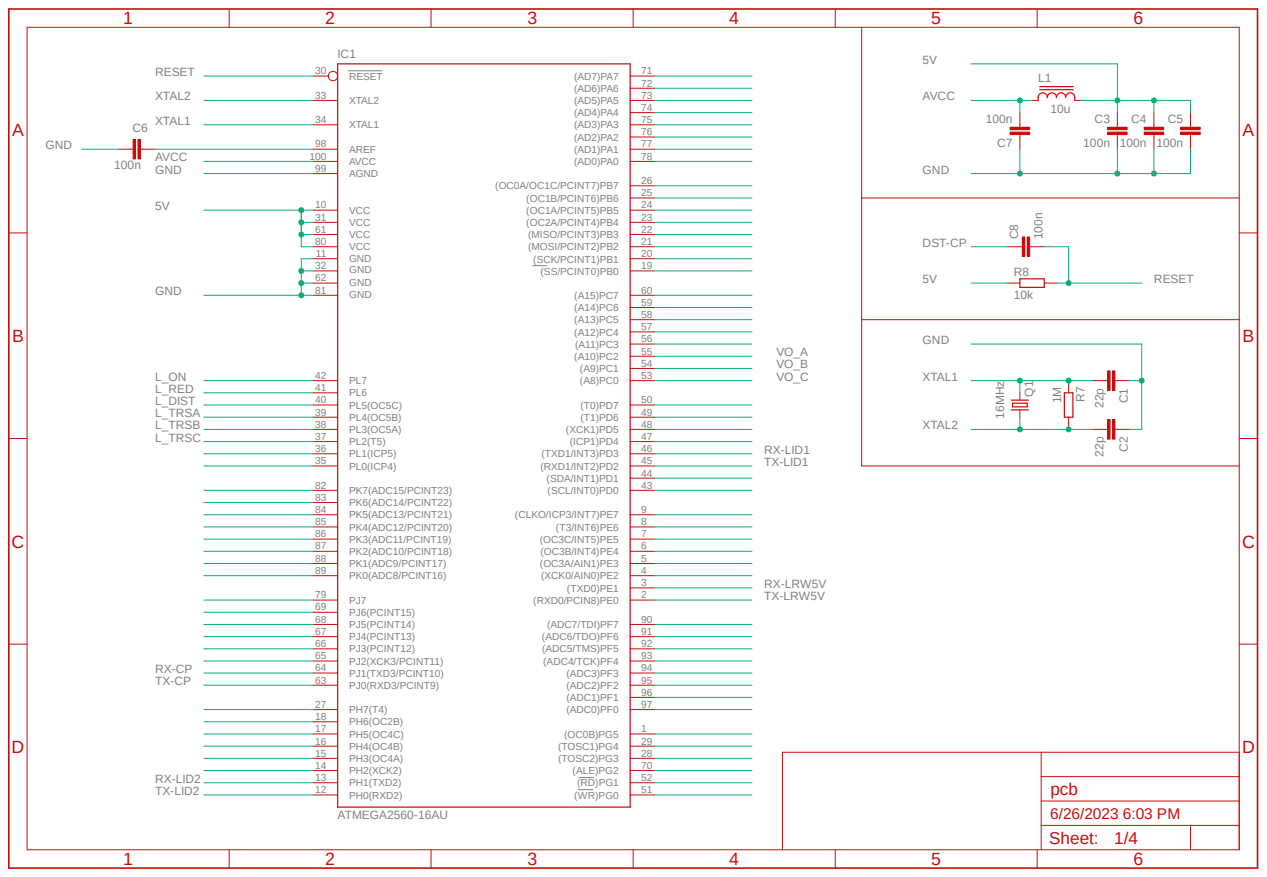
[picture p54: page 1]

A

A

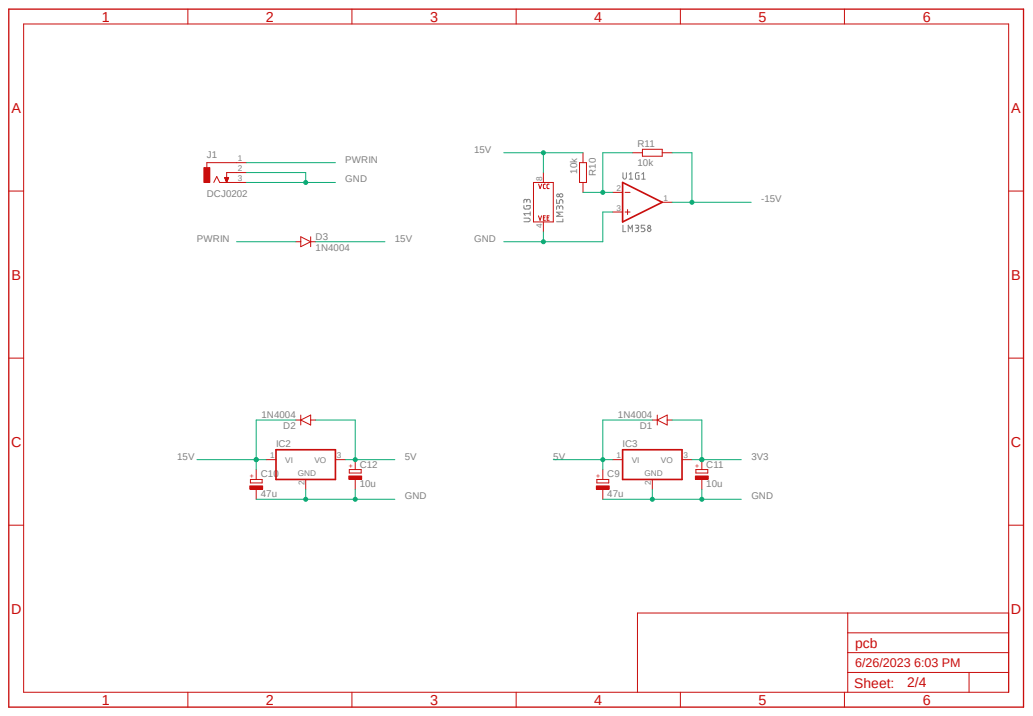
[picture p55: page 2]

A

A

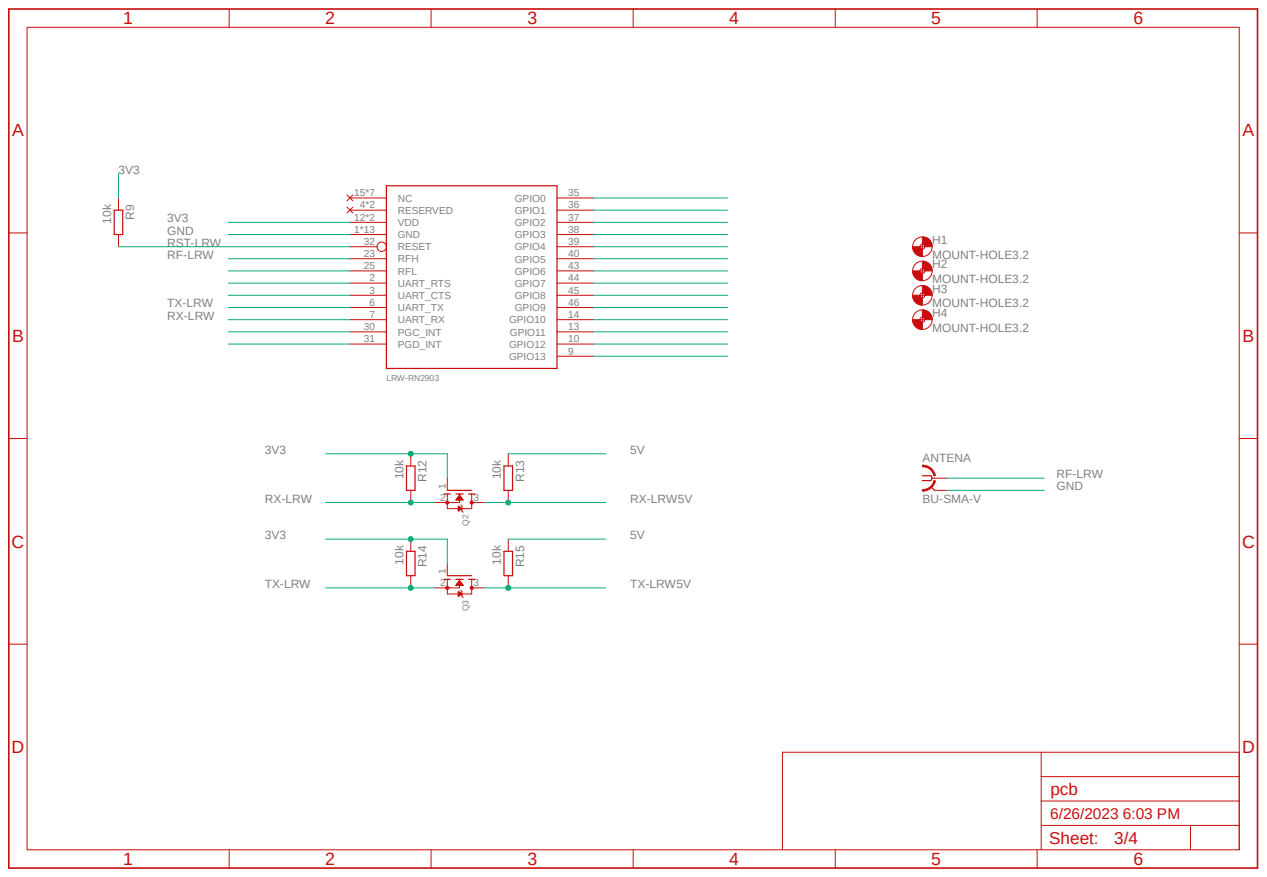
[picture p56: page 3]
MOUNT-HOLE3.2; MOUNT-HOLE3.2 ¹⁰k; BU-SMA-V ¹⁰k; UART_RTS 2 UART_CTS 3; RESERVED 4*2; UART_TX 6 UART_RX 7; GND 1*13; GPIO13; GPIO12; 10 GPIO11; 13 GPIO10; RFH 23 RFL 25; PGC_INT 30 PGD_INT 31; VDD 12*2; GPIO0; GPIO1; GPIO2; GPIO3; GPIO4; GPIO5; GPIO6; GPIO7; GPIO8; GPIO9; RESET 32; LRW-RN2903; ANTENA; 3Q² R¹²; R¹³; 3Q³ R¹⁴; R¹⁵; RST-LRW; RX-LRW; RF-LRW; TX-LRW; GND; RX-LRW5V; TX-LRW5V; Sheet:; pcb

Sheet: ABCD | 1 | 2 | 3 | 4 | 5 | 6 | ABCD 1 | 2 | 3 | 4 | 5 | 6

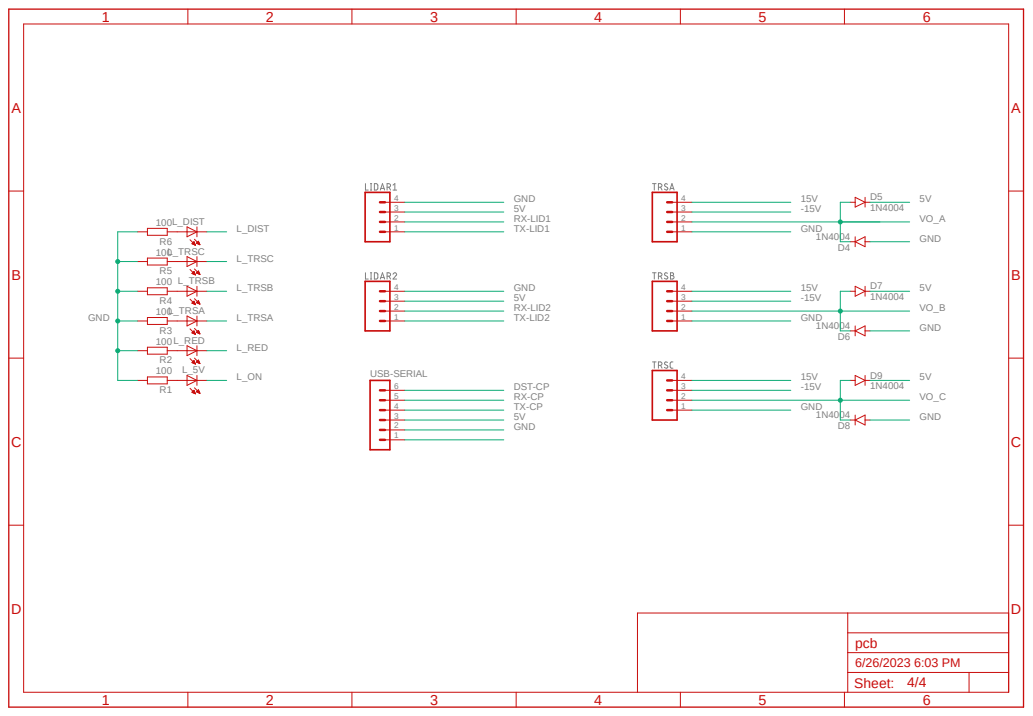
[picture p57: page 4]
