leslieecv/EL6050_project/T3/diagrama_bloques.pdf

# RN2903 LED_ON

# Diagrama de bloques

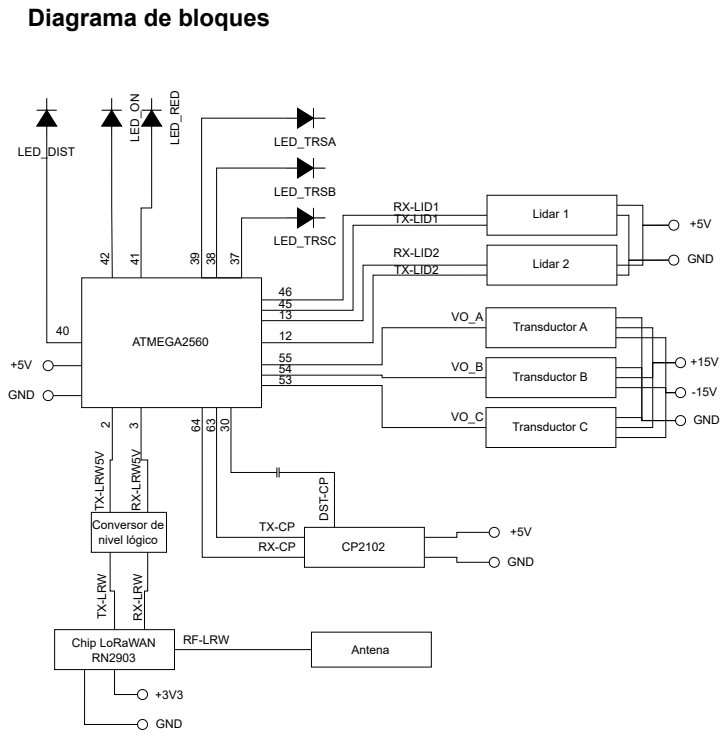
[picture p58: page 1]
ATMEGA2560; Antena; Transductor A; Transductor B; Transductor C; Chip LoRaWAN; Lidar 2; LED_DIST; LED_RED; LED_TRSA; LED_TRSB; Lidar 1; RX-LID1; GND; DST-CP; RF-LRW; Conversor de; nivel lógico TX⁻LRW⁵V; RX⁻LRW⁵V

TX-LID1

LED_TRSC | RX-LID2

TX-LID2
