leslieecv/EL6050_project/Examen/Archivos/Open_Loop_Current_Sensor_CS10000hb.pdf

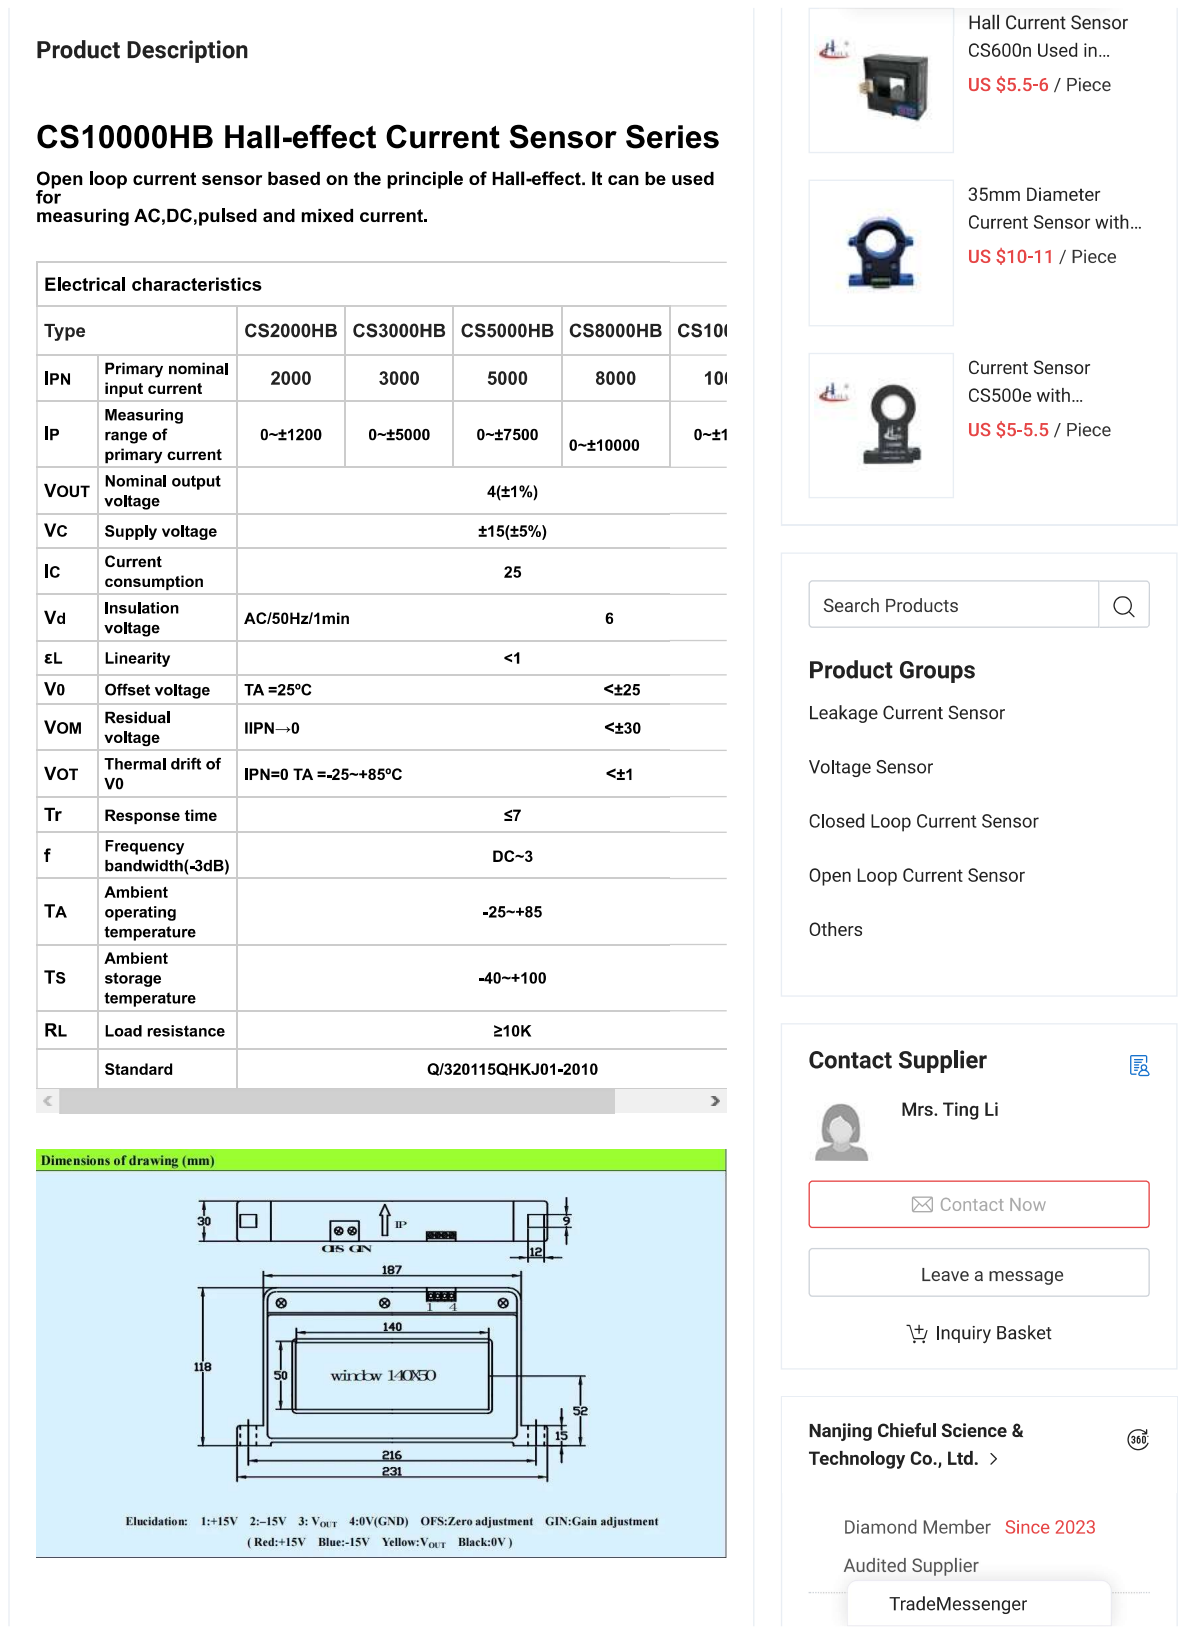
[picture p59: page 1]
