leslieecv/EL6050_project/Examen/Imagenes/Presentación/dashboard.pdf

# Monitoreo Electricidad Hospital San Borja

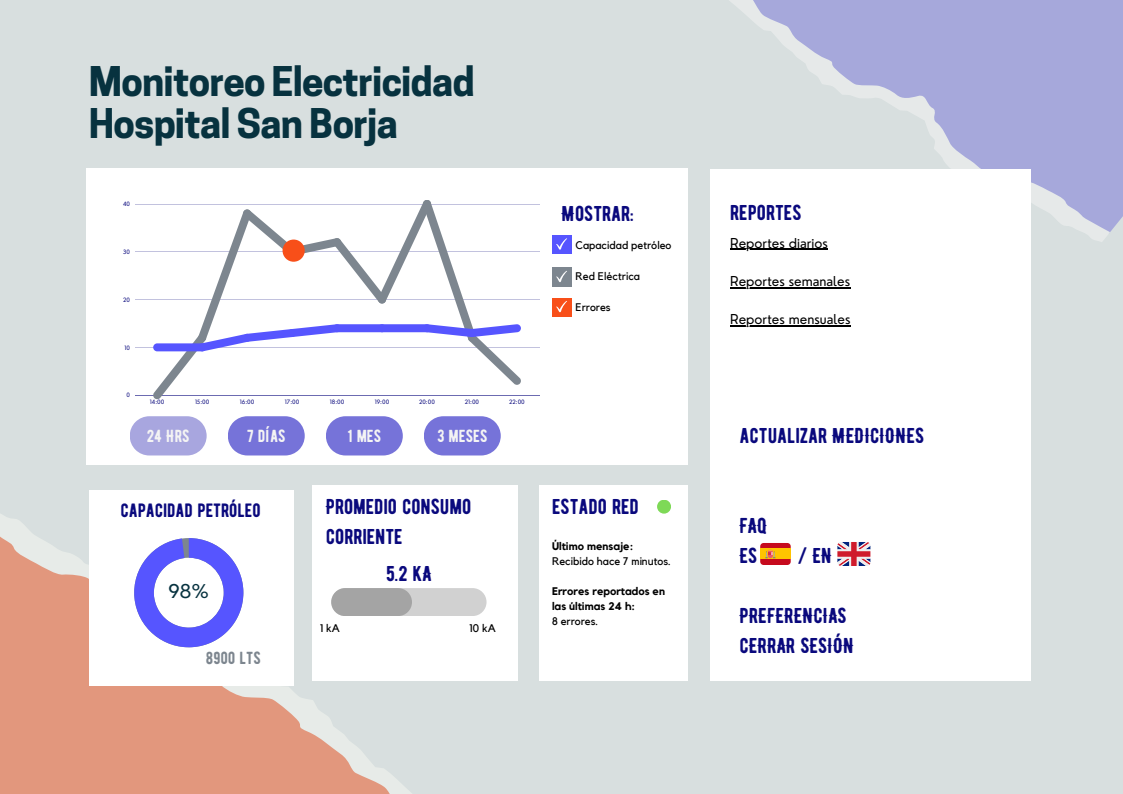
[picture p60: page 1]
Mostrar:; Capacidad petróleo; Red Eléctrica; Errores; 24 Hrs; 7 días; 1 mes; 3 meses; estado red; actualizar MEDICIONES; FAQ; PREFERENCIAS cERRAR SESIÓN; Promedio consumo corriente; capacidad petróleo; reportes; Reportes diarios; Reportes semanales; Reportes mensuales; 8900 lts

Último mensaje:
Recibido hace 7 minutos.

Errores reportados en
las últimas 24 h:
8 errores.
