leslieecv/EL6050_project/Examen/PCB/pcb.brd

## EAGLE design Examen/PCB/pcb.brd (2023-06-30)

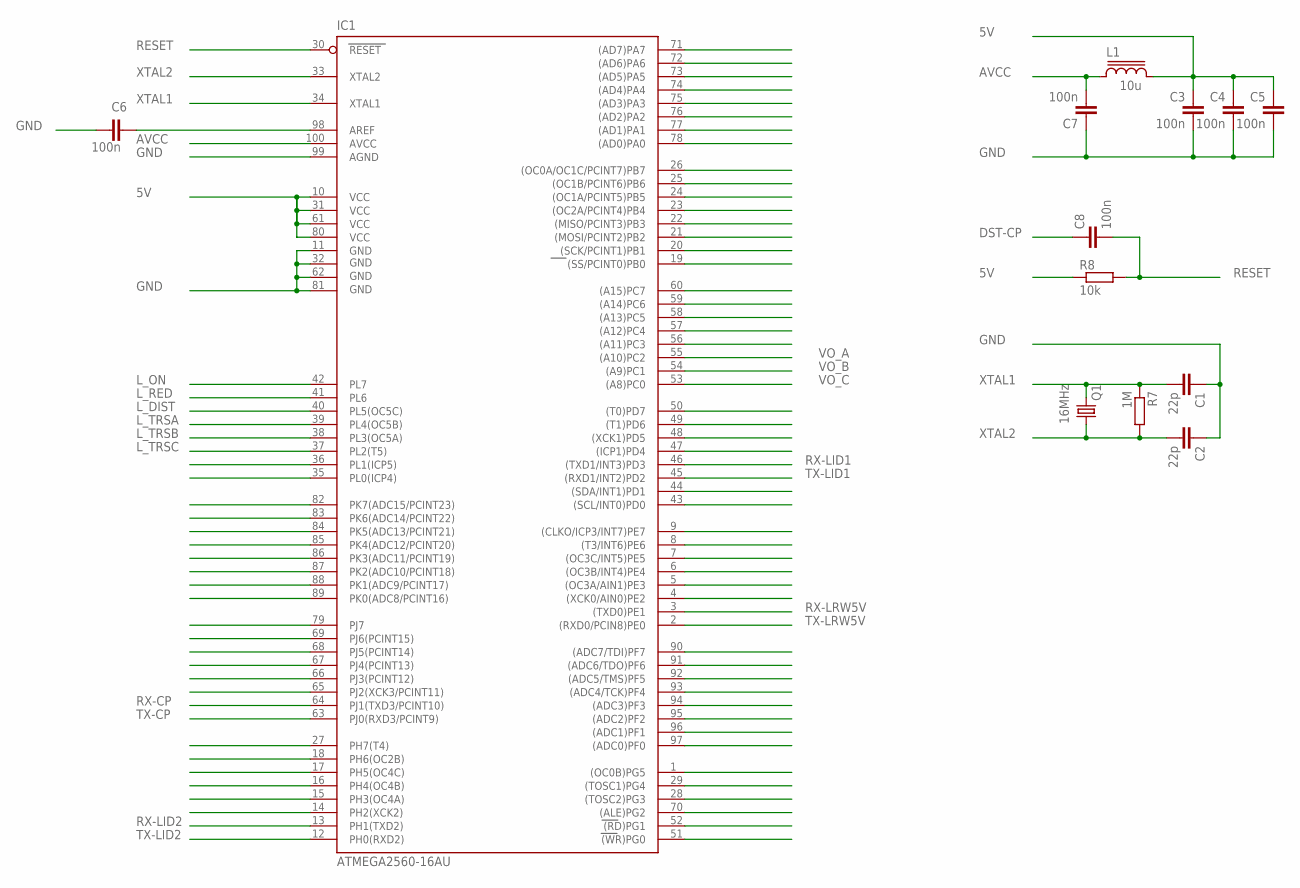
[picture p61: schematic pcb.sch, sheet 1, Microcontrolador]

Parts:
C1, C2: 22p; C050-025X075
C3, C4, C5, C6, C7, C8: 100n; C050-025X075
IC1: ATMEGA2560-16AU; TQFP100
L1: 10u; MSS1260
Q1: 16MHz; HC18U-V
R7: 1M; R1206W
R8: 10k; R1206W

Connections:
5V: C3.2, C4.2, C5.2, IC1.10 (VCC), IC1.31 (VCC1), IC1.61 (VCC2), IC1.80 (VCC3), L1.2, R8.1; also elsewhere on the board
AVCC: C7.2, IC1.100 (AVCC), L1.1
DST-CP: C8.1; also elsewhere on the board
GND: C1.1, C2.1, C3.1, C4.1, C5.1, C6.2, C7.1, IC1.11 (GND), IC1.32 (GND1), IC1.62 (GND2), IC1.81 (GND3), IC1.99 (AGND); also elsewhere on the board
L_DIST: IC1.40 (PL5(OC5C)); also elsewhere on the board
L_ON: IC1.42 (PL7); also elsewhere on the board
L_RED: IC1.41 (PL6); also elsewhere on the board
L_TRSA: IC1.39 (PL4(OC5B)); also elsewhere on the board
L_TRSB: IC1.38 (PL3(OC5A)); also elsewhere on the board
L_TRSC: IC1.37 (PL2(T5)); also elsewhere on the board
unnamed: C6.1, IC1.98 (AREF)
RESET: C8.2, IC1.30 (RESET), R8.2
RX-CP: IC1.64 (PJ1(TXD3/PCINT10)); also elsewhere on the board
RX-LID1: IC1.46 ((TXD1/INT3)PD3); also elsewhere on the board
RX-LID2: IC1.13 (PH1(TXD2)); also elsewhere on the board
RX-LRW5V: IC1.3 ((TXD0)PE1); also elsewhere on the board
TX-CP: IC1.63 (PJ0(RXD3/PCINT9)); also elsewhere on the board
TX-LID1: IC1.45 ((RXD1/INT2)PD2); also elsewhere on the board
TX-LID2: IC1.12 (PH0(RXD2)); also elsewhere on the board
TX-LRW5V: IC1.2 ((RXD0/PCIN8)PE0); also elsewhere on the board
VO_A: IC1.55 ((A10)PC2); also elsewhere on the board
VO_B: IC1.54 ((A9)PC1); also elsewhere on the board
VO_C: IC1.53 ((A8)PC0); also elsewhere on the board
XTAL1: C1.2, IC1.34 (XTAL1), Q1.1, R7.1
XTAL2: C2.2, IC1.33 (XTAL2), Q1.2, R7.2

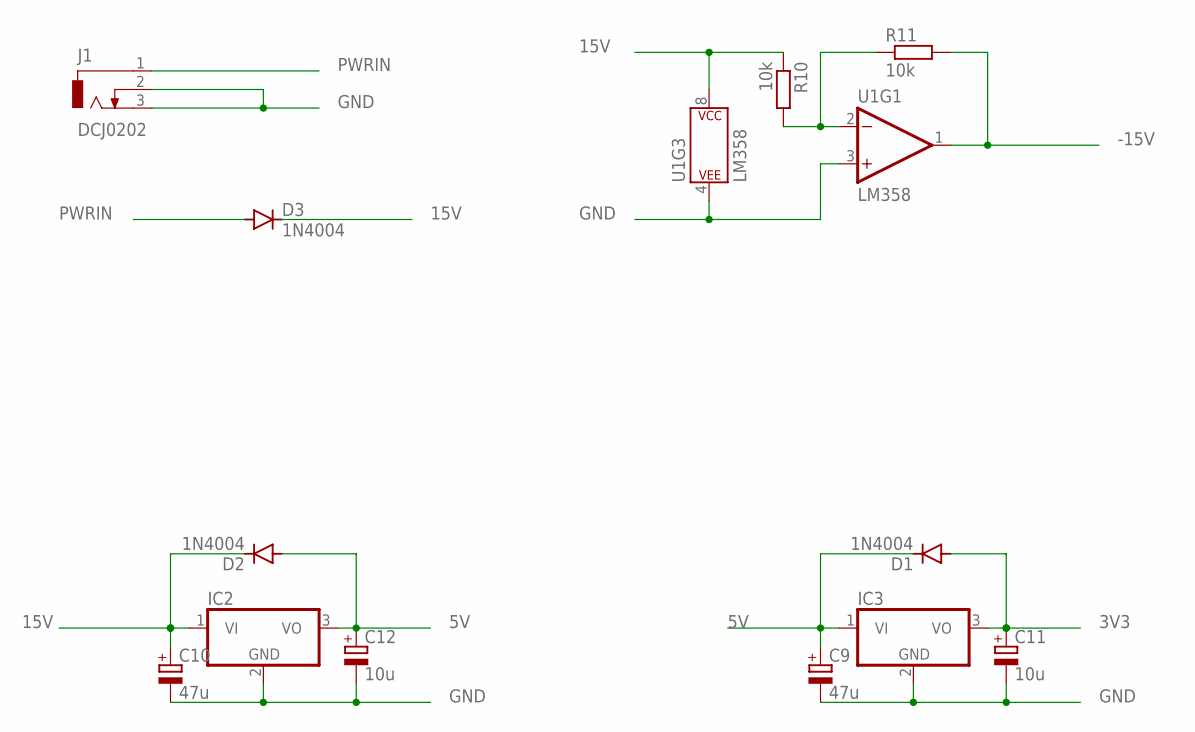
[picture p62: schematic pcb.sch, sheet 2, Alimentación y voltajes de la placa]

Parts:
C9, C10: 47u; E2,5-6E
C11, C12: 10u; E2,5-6E
D1, D2, D3: 1N4004; DO41-10
IC2, IC3: 7805T; TO220H
J1: DCJ0202
R10, R11: 10k; R1206W
U1: LM358; DIP08

Connections:
3V3: C11.+, D1.A, IC3.3 (VO); also elsewhere on the board
5V: C9.+, C12.+, D1.C, D2.A, IC2.3 (VO), IC3.1 (VI); also elsewhere on the board
15V: C10.+, D2.C, D3.C, IC2.1 (VI), R10.1, U1.8 (P$V+); also elsewhere on the board
-15V: R11.2, U1.1 (OUT); also elsewhere on the board
GND: C9.-, C10.-, C11.-, C12.-, IC2.2 (GND), IC3.2 (GND), J1.2, J1.3, U1.3 (+IN), U1.4 (P$V-); also elsewhere on the board
unnamed: R10.2, R11.1, U1.2 (-IN)
PWRIN: D3.A, J1.1

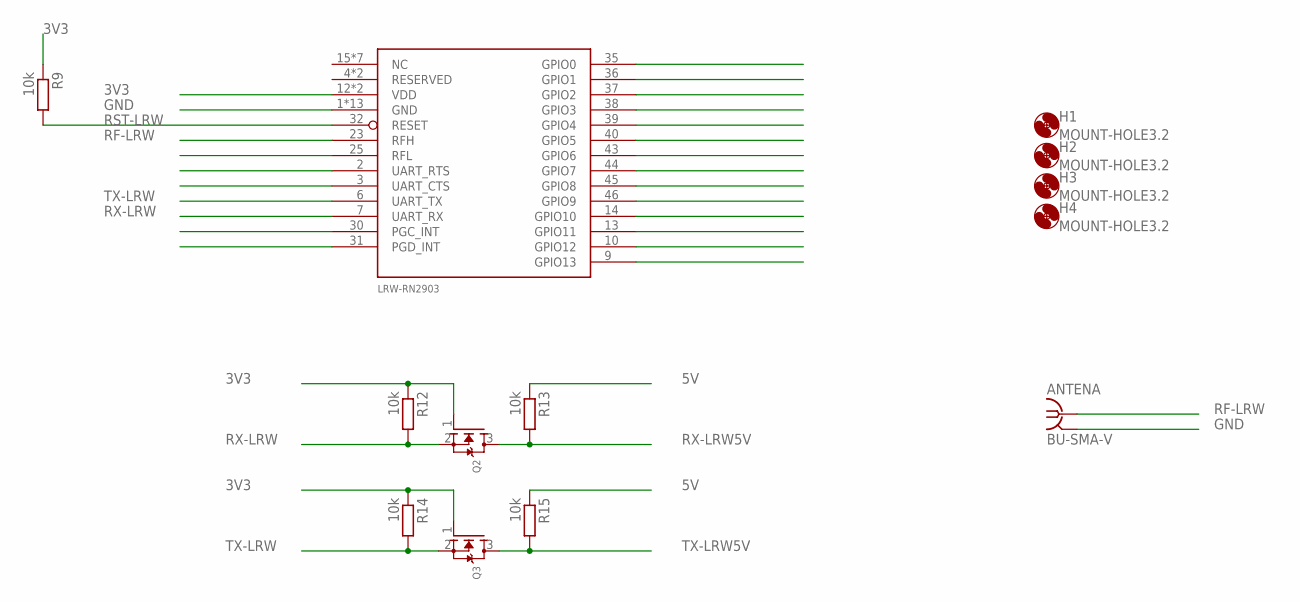
[picture p63: schematic pcb.sch, sheet 3, Modulo LoraWAN]

Parts:
ANTENA: BU-SMA-V
H1, H2, H3, H4: MOUNT-HOLE3.2; 3,2
LRW-RN2903: MICROCHIP_RN2483
Q2, Q3: MOSFET-NWAVE; SOT23-W
R9, R12, R13, R14, R15: 10k; R1206W

Connections:
3V3: LRW-RN2903.12 (VDD), LRW-RN2903.34 (VDD), Q2.1 (G), Q3.1 (G), R9.1, R12.1, R14.1; also elsewhere on the board
5V: R13.1, R15.1; also elsewhere on the board
GND: ANTENA.2, ANTENA.3 (2), ANTENA.4 (2), ANTENA.5 (2), LRW-RN2903.1 (GND), LRW-RN2903.8 (GND), LRW-RN2903.11 (GND), LRW-RN2903.20 (GND), LRW-RN2903.21 (GND), LRW-RN2903.22 (GND), LRW-RN2903.24 (GND), LRW-RN2903.26 (GND), LRW-RN2903.27 (GND), LRW-RN2903.28 (GND), LRW-RN2903.33 (GND), LRW-RN2903.41 (GND), LRW-RN2903.47 (GND); also elsewhere on the board
RF-LRW: ANTENA.1, LRW-RN2903.23 (RFH)
RST-LRW: LRW-RN2903.32 (RESET), R9.2
RX-LRW: LRW-RN2903.7 (UART_RX), Q2.2 (S), R12.2
RX-LRW5V: Q2.3 (D), R13.2; also elsewhere on the board
TX-LRW: LRW-RN2903.6 (UART_TX), Q3.2 (S), R14.2
TX-LRW5V: Q3.3 (D), R15.2; also elsewhere on the board

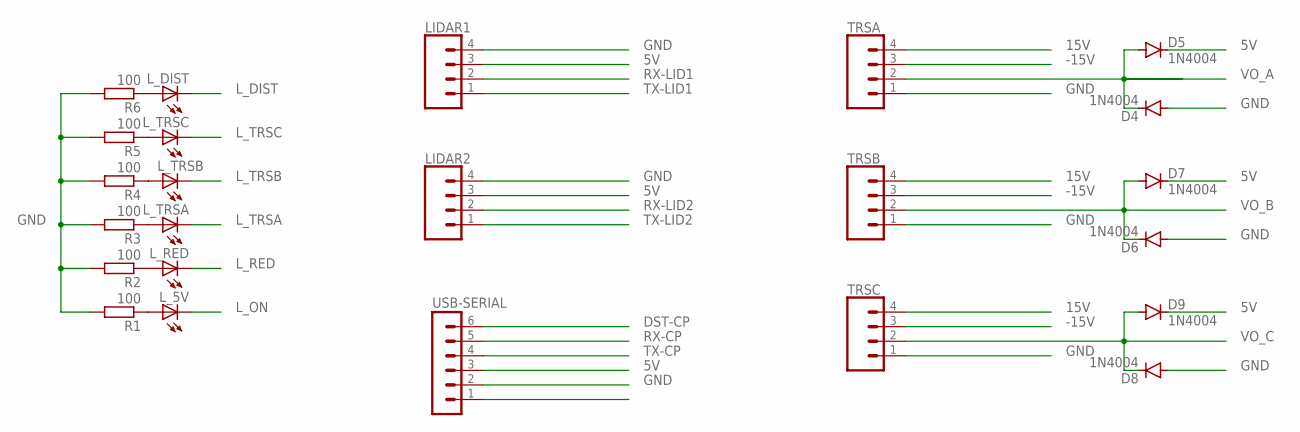
[picture p64: schematic pcb.sch, sheet 4, Perifericos: sensores, leds y conversor]

Parts:
D4, D5, D6, D7, D8, D9: 1N4004; DO41-10
LIDAR1, LIDAR2: CONN_04JST-PTH; JST-4-PTH
L_5V: LED5MM
L_DIST: LED5MM
L_RED: LED5MM
L_TRSA: LED5MM
L_TRSB: LED5MM
L_TRSC: LED5MM
R1, R2, R3, R4, R5, R6: 100; R1206W
TRSA: CONN_04JST-PTH; JST-4-PTH
TRSB: CONN_04JST-PTH; JST-4-PTH
TRSC: CONN_04JST-PTH; JST-4-PTH
USB-SERIAL: MA06-1

Connections:
5V: D5.C, D7.C, D9.C, LIDAR1.3, LIDAR2.3, USB-SERIAL.3; also elsewhere on the board
15V: TRSA.4, TRSB.4, TRSC.4; also elsewhere on the board
-15V: TRSA.3, TRSB.3, TRSC.3; also elsewhere on the board
DST-CP: USB-SERIAL.6; also elsewhere on the board
GND: D4.A, D6.A, D8.A, LIDAR1.4, LIDAR2.4, R1.2, R2.2, R3.2, R4.2, R5.2, R6.2, TRSA.1, TRSB.1, TRSC.1, USB-SERIAL.2; also elsewhere on the board
L_DIST: L_DIST.K (C); also elsewhere on the board
L_ON: L_5V.K (C); also elsewhere on the board
L_RED: L_RED.K (C); also elsewhere on the board
L_TRSA: L_TRSA.K (C); also elsewhere on the board
L_TRSB: L_TRSB.K (C); also elsewhere on the board
L_TRSC: L_TRSC.K (C); also elsewhere on the board
unnamed: L_TRSB.A, R4.1
unnamed: L_5V.A, R1.1
unnamed: L_RED.A, R2.1
unnamed: L_TRSA.A, R3.1
unnamed: L_TRSC.A, R5.1
unnamed: L_DIST.A, R6.1
RX-CP: USB-SERIAL.5; also elsewhere on the board
RX-LID1: LIDAR1.2; also elsewhere on the board
RX-LID2: LIDAR2.2; also elsewhere on the board
TX-CP: USB-SERIAL.4; also elsewhere on the board
TX-LID1: LIDAR1.1; also elsewhere on the board
TX-LID2: LIDAR2.1; also elsewhere on the board
VO_A: D4.C, D5.A, TRSA.2; also elsewhere on the board
VO_B: D6.C, D7.A, TRSB.2; also elsewhere on the board
VO_C: D8.C, D9.A, TRSC.2; also elsewhere on the board

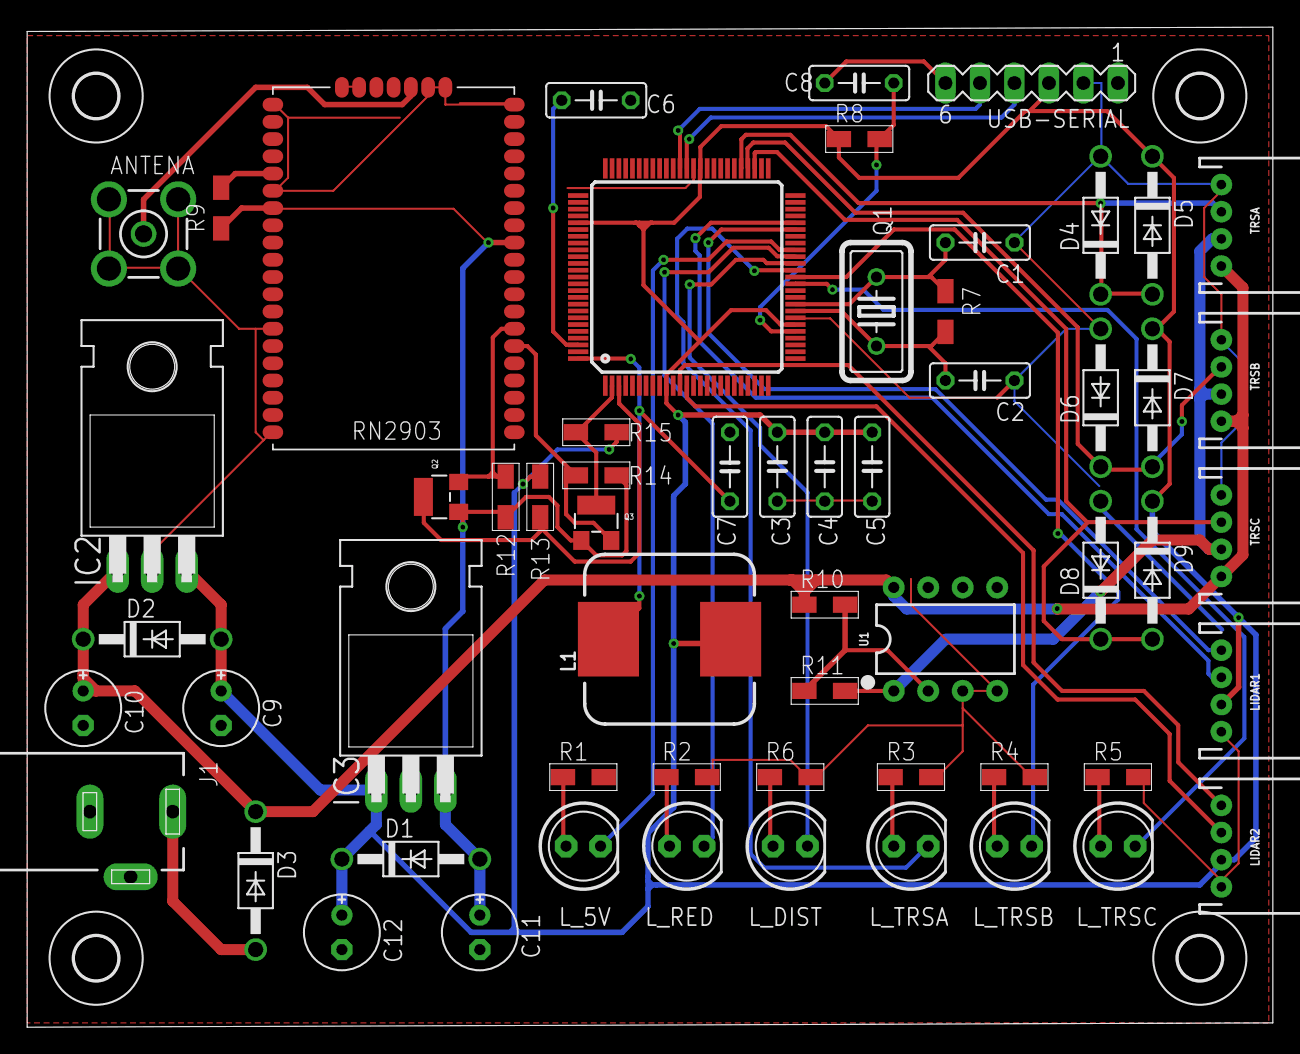
[picture p65: board pcb.brd from above]

Board: 2 copper layers, 91.7 x 73.6 mm, 63 parts (0 on the bottom side), 40 nets.
