leslieecv/EL6050_project/(commit log)

2023-05-30 add lorawan module and arduino to schematic
    [pcb.brd, pcb.sch]
2023-06-09 add and connect components
    [pcb.brd, pcb.sch]
2023-06-22 all components added and board started
    [pcb.brd, pcb.sch]
2023-06-26 end board and update schematic
    [pcb.brd, pcb.sch]
2023-06-30 hardware complete
    [pcb.brd, pcb.sch]
2023-06-30 start main and lidar related code
2023-06-30 update lidar state machine
2023-07-03 Update main.ino
    agregue libreria eeprom para guardar errores en la memoria no volatil
    [main.ino]
2023-07-04 update lidar
2023-07-12 add all files
    [Ejecución_del_proyecto.xlsx, caja_EL6050.f3z, pcb.brd, pcb.sch]
