leslieecv/EL6050_project/(notices)

Notices in the files:
parts and their libraries:
sparkfun-connectors: Licensing: Creative Commons ShareAlike 4.0 International - https://creativecommons.org/licenses/by-sa/4.0
